takinoya/EvbPusher/FW.Arduino/Readme.md

Supported Main Boards

- AVR based
    - MB-C2 with Arduino Nano
    - MB-C2 with Arduino Nano Every
- Renesas R4 based
    - MB-C2 with Arduino Nano R4
- RP2040 based
    - MB-95x27 (Seeed Xiao RP2040)
    - MB-B1 (AE-RP2040 as RaspberryPI-Pico)
- RP2350 based
    - (Planning...)
