takinoya/EvbPusher/Supplemental/AE-RELAY4-BOARD.SATA-Power-SW/README.ja.md

[English](README.md) | [日本語](README.ja.md)
----

# AE-RELAY4-BOARD SATA-Power switching Custom

## Overview
TBD
