takinoya/EvbPusher/Supplemental/AE-RELAY4-BOARD.SATA-Power-SW/README.md

[English](README.md) | [Japanese](README.ja.md)
----

# SFX Power Complex

TBD
\(Original is here ==> [Japanese](README.ja.md)\)
