takinoya/EvbPusher/Supplemental/SFX-Breakout/README.md

[English](README.md) | [Japanese](README.ja.md)
----

# SFX Breakout board

TBD
\(Original is here ==> [Japanese](README.ja.md)\)
