takinoya/EvbPusher/Supplemental/SFX-Breakout/Shell/SFX-BO-01_Top-Panel_Acrylic-cut.intermediate.pdf

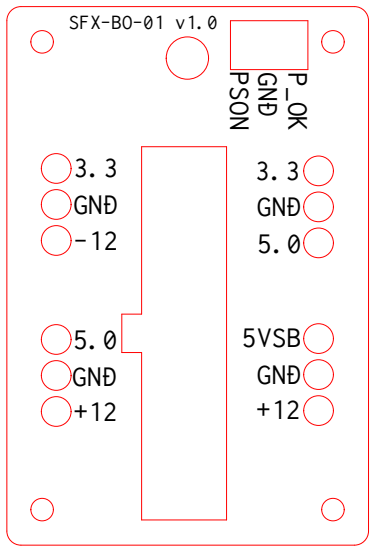
[picture p3: figure]
3. 3 GND -12; 5. 0 GND; GND; 5VSB; 3. 3 PSON GND P_OK; SFX-BO-01 v1. 0
