takinoya/EvbPusher/MB-C1.Arduino_Nano_Every/Shell/03_Acryl-cover.cut.pdf

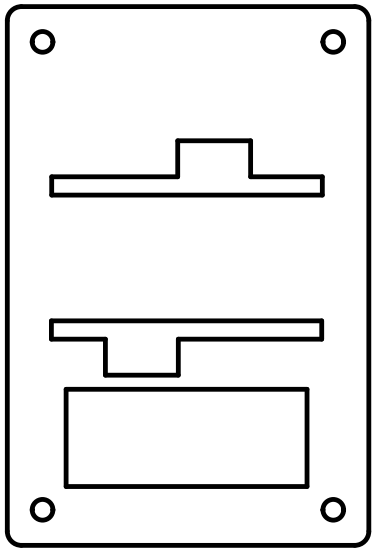
[picture p4: figure]
