takinoya/EvbPusher/MB-C1.Arduino_Nano_Every/photo/PXL_20251028_014240596.jpg

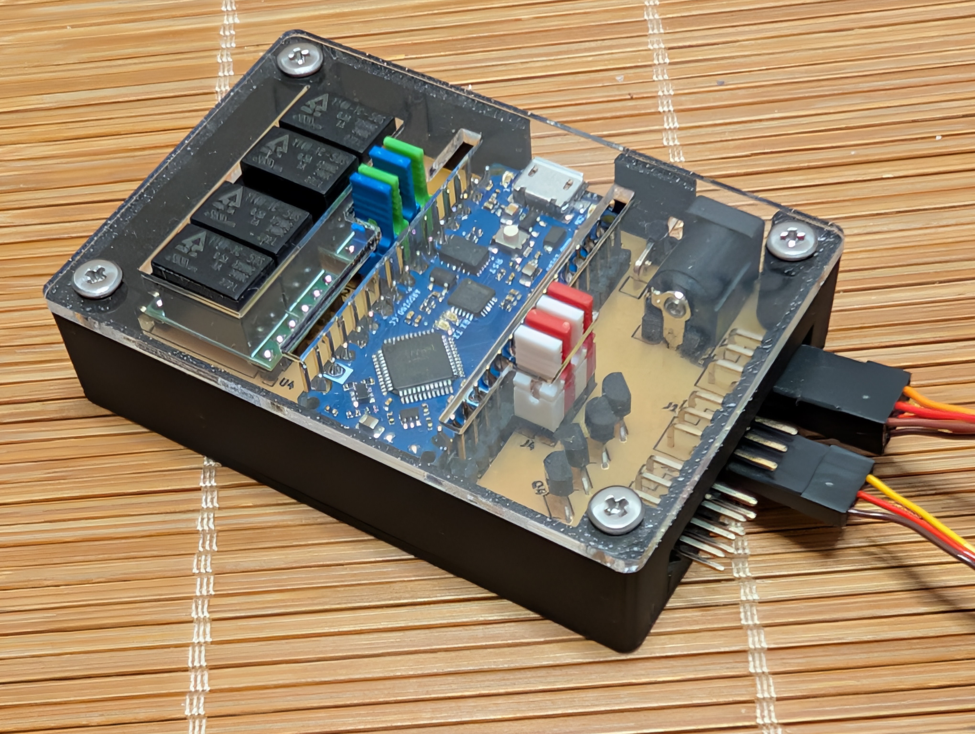
MB-C1.Arduino_Nano_Every/photo/PXL_20251028_014240596.jpg
