takinoya/EvbPusher/MB-C2.Auduino_Nano_R4/Photos/PXL_20251215_010732840.jpg

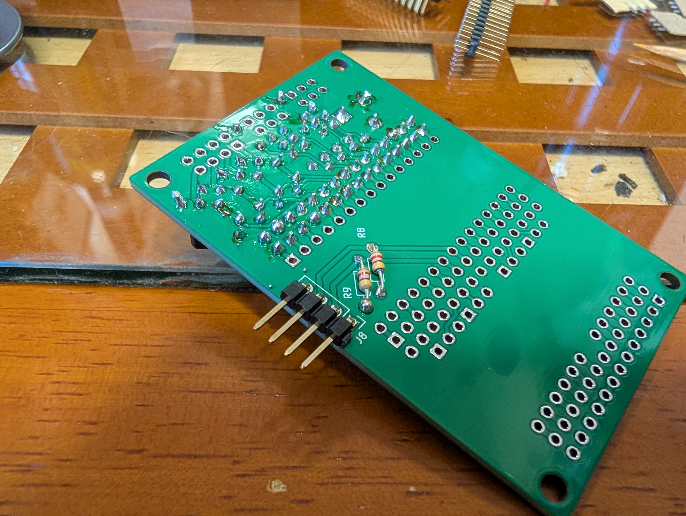
MB-C2.Auduino_Nano_R4/Photos/PXL_20251215_010732840.jpg
