takinoya/EvbPusher/MB-C2.Auduino_Nano_R4/Photos/PXL_20251215_010748415.jpg

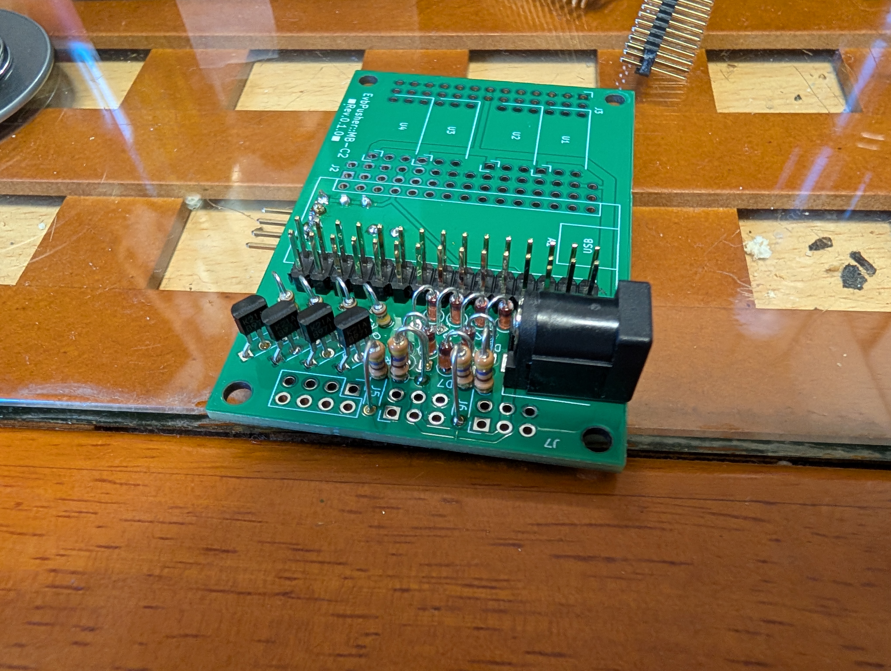
MB-C2.Auduino_Nano_R4/Photos/PXL_20251215_010748415.jpg
