takinoya/EvbPusher/MB-C2.Auduino_Nano_R4/Photos/PXL_20260118_062052821.jpg

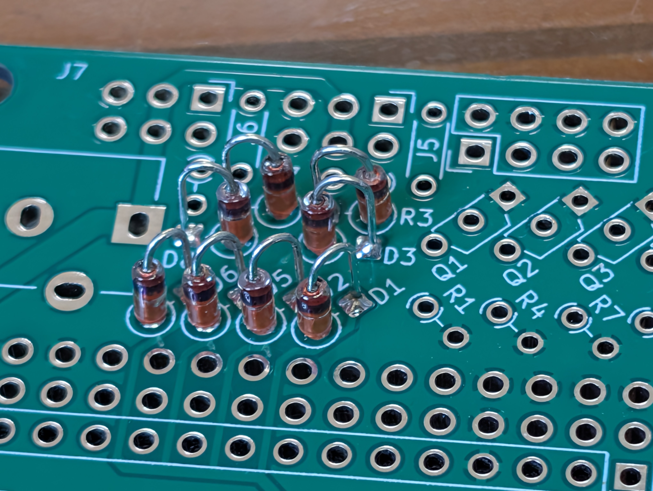
MB-C2.Auduino_Nano_R4/Photos/PXL_20260118_062052821.jpg
