takinoya/EvbPusher/MB-C2.Auduino_Nano_R4/Photos/PXL_20260118_070423665.jpg

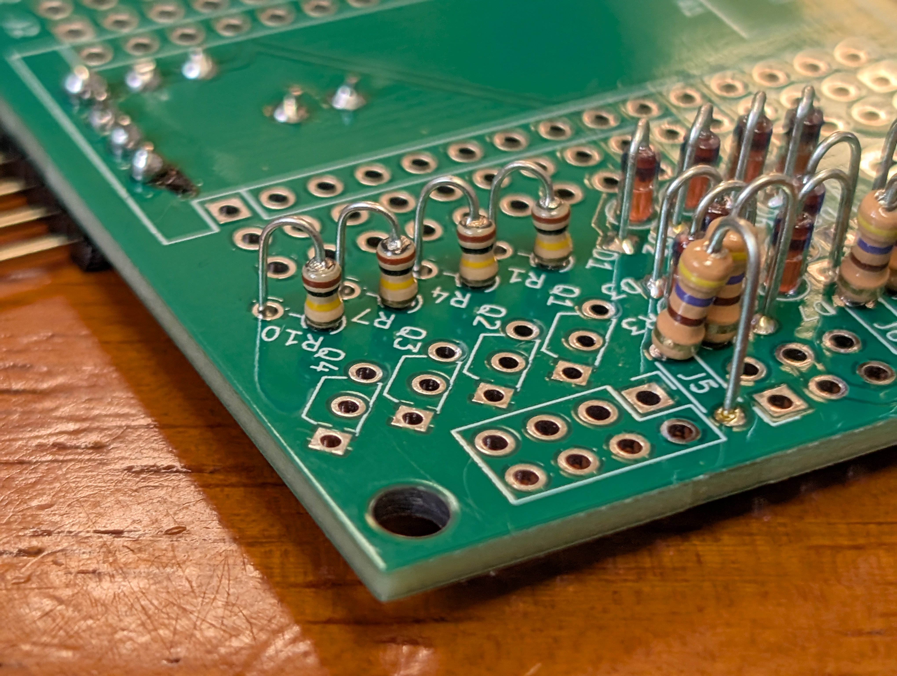
MB-C2.Auduino_Nano_R4/Photos/PXL_20260118_070423665.jpg
