takinoya/EvbPusher/Supplemental/AE-RELAY953B-5V.SATA-Power-SW/photo/PXL_20251104_105322829.jpg

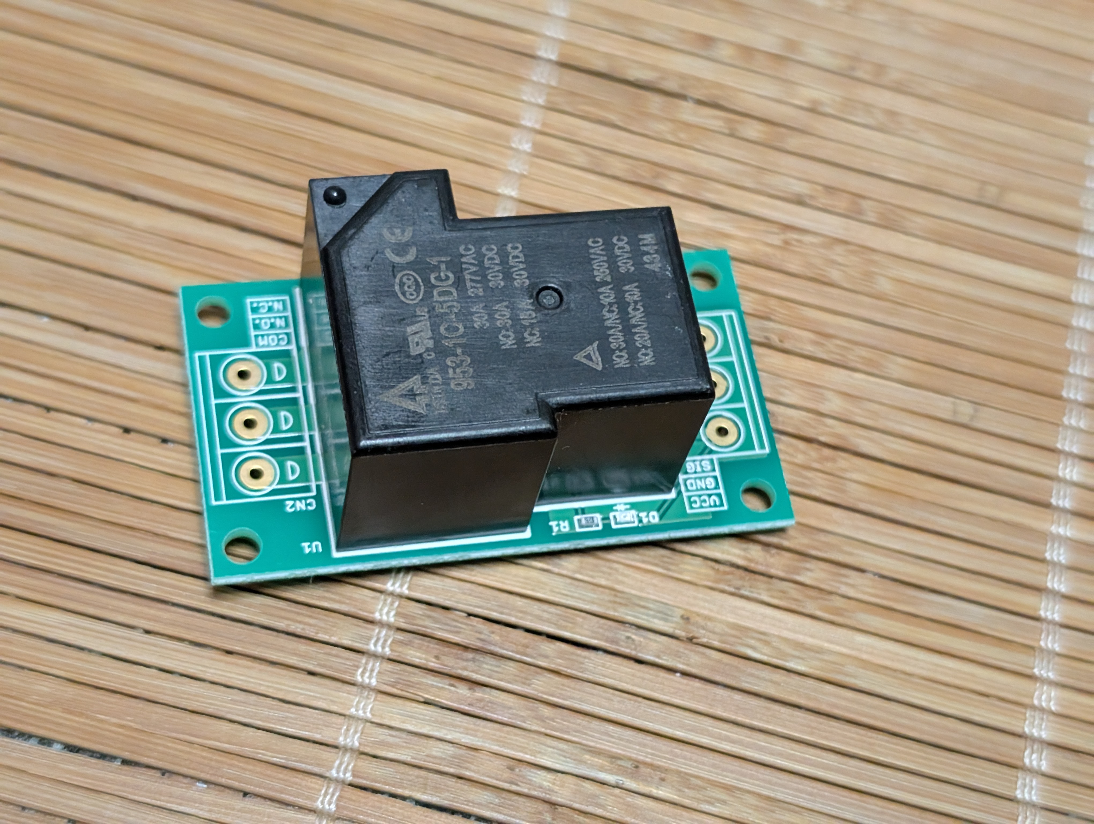
Supplemental/AE-RELAY953B-5V.SATA-Power-SW/photo/PXL_20251104_105322829.jpg
