takinoya/EvbPusher/Supplemental/AE-RELAY953B-5V.SATA-Power-SW/photo/PXL_20251105_040740281.jpg

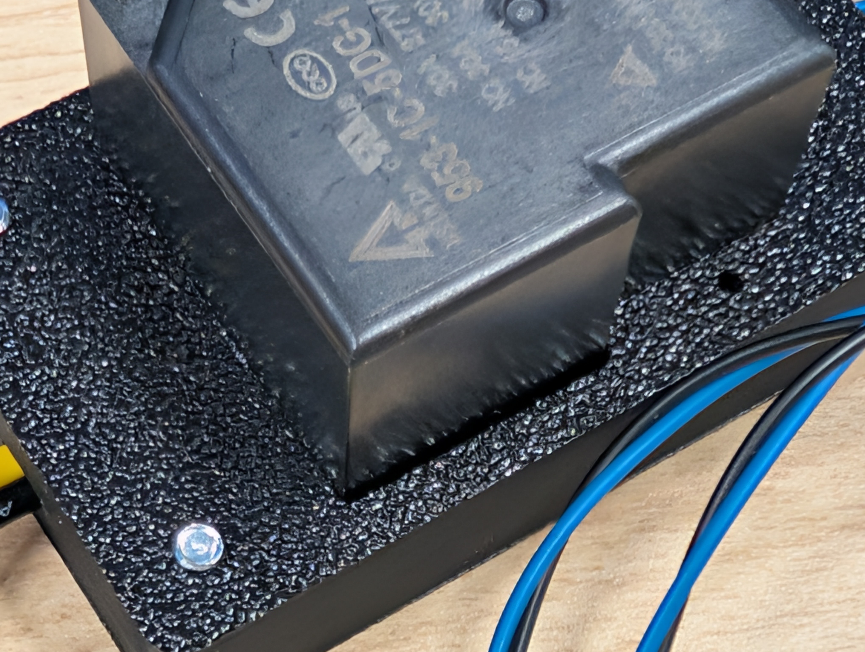
Supplemental/AE-RELAY953B-5V.SATA-Power-SW/photo/PXL_20251105_040740281.jpg
