takinoya/EvbPusher/MB-C1.Arduino_Nano_Every/Shell/02_Top_main_v2.FCStd

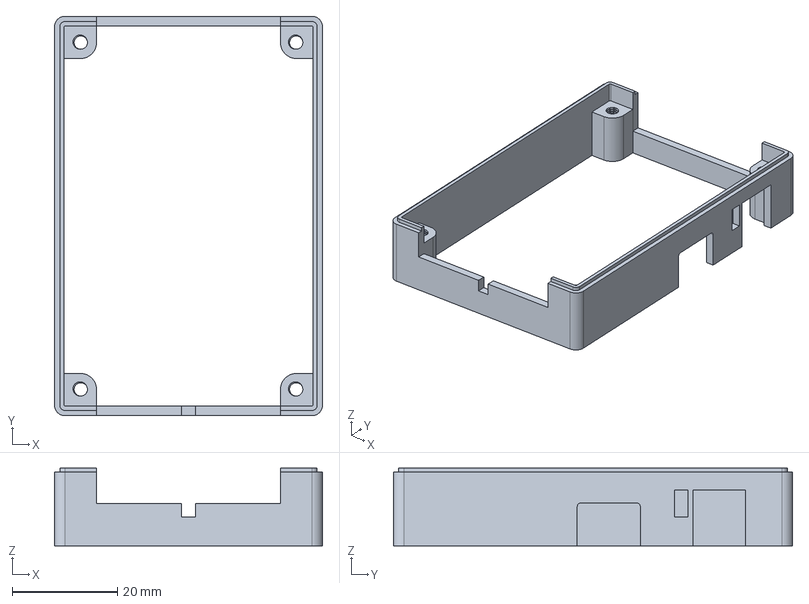
[picture p20: CAD file, 2025-10-31]
MB-C1.Arduino_Nano_Every/Shell/02_Top_main_v2.FCStd
51.0 x 76.0 x 14.8 mm
