takinoya/EvbPusher/MB-C2.Auduino_Nano_R4/Shell/02_Main_body.3mf

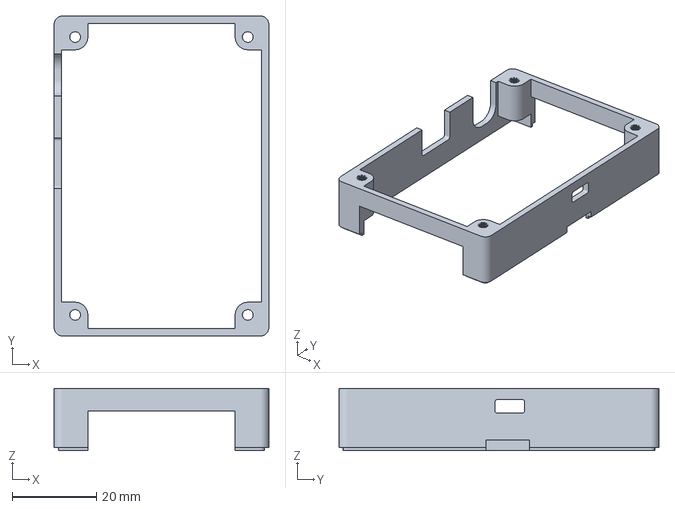
[picture p21: CAD file, 2026-03-13]
MB-C2.Auduino_Nano_R4/Shell/02_Main_body.3mf
51.0 x 76.0 x 14.8 mm
