takinoya/EvbPusher/MB-C1.Arduino_Nano_Every/Shell/01_Bottom_panel_v2-Body.3mf

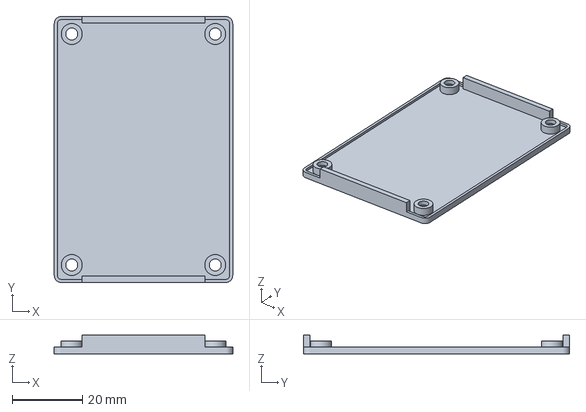
[picture p22: CAD file, 2025-10-31]
MB-C1.Arduino_Nano_Every/Shell/01_Bottom_panel_v2-Body.3mf
51.0 x 76.0 x 5.34 mm
