takinoya/EvbPusher/MB-C2.Auduino_Nano_R4/Shell/MB-C2_Shell.FCStd

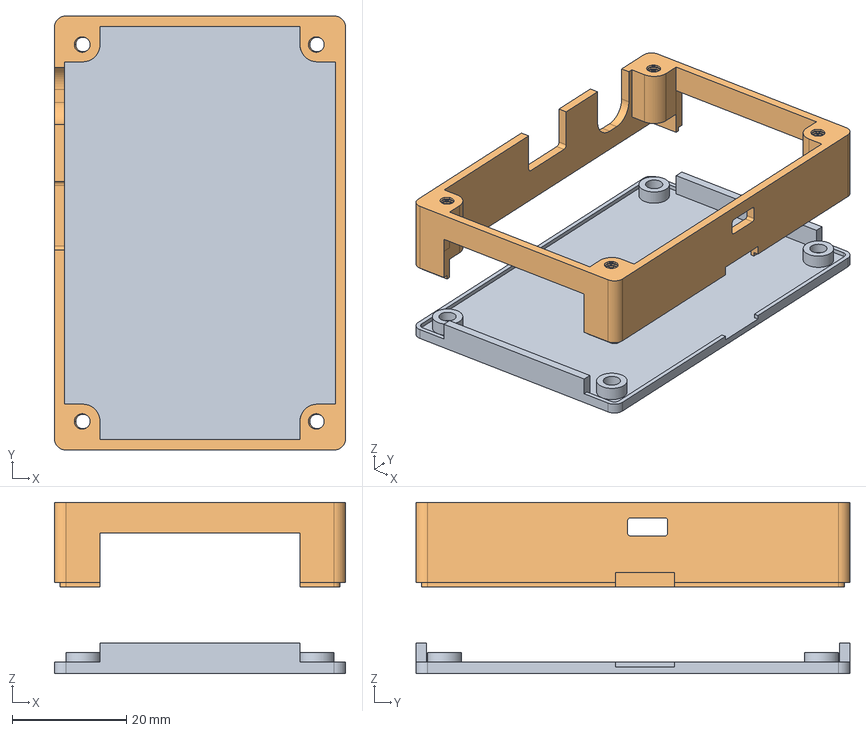
[picture p23: CAD file, 2026-03-13]
MB-C2.Auduino_Nano_R4/Shell/MB-C2_Shell.FCStd
51.0 x 76.0 x 30.0 mm
01_Bottom_panel
02_Main_body
