takinoya/EvbPusher/Supplemental/AE-RELAY953B-5V.SATA-Power-SW/ORCA.Shell_for_AE-RELAY953B.3mf

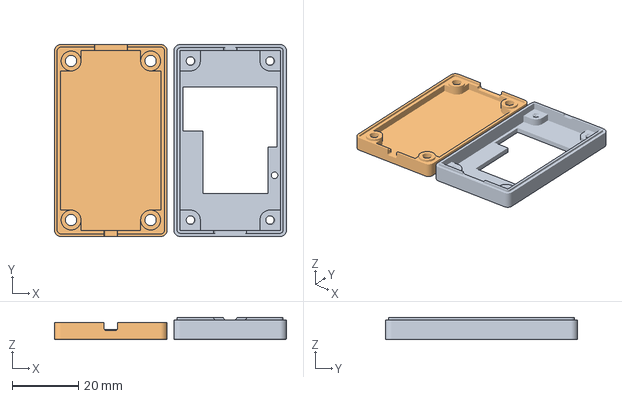
[picture p24: CAD file, 2025-11-11]
Supplemental/AE-RELAY953B-5V.SATA-Power-SW/ORCA.Shell_for_AE-RELAY953B.3mf
70.0 x 58.0 x 6.74 mm
