takinoya/EvbPusher/Supplemental/SFX-Breakout/Shell/SFX-BO-01_Shell-North-Body.3mf

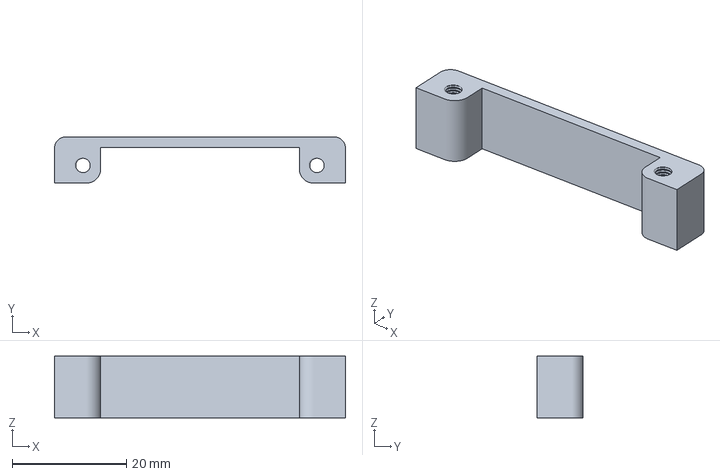
[picture p25: CAD file, 2026-03-12]
Supplemental/SFX-Breakout/Shell/SFX-BO-01_Shell-North-Body.3mf
51.0 x 8.10 x 10.8 mm
