takinoya/EvbPusher/Supplemental/AE-RELAY953B-5V.SATA-Power-SW/Shell_for_AE-RELAY953B-5V-Bottom-panel-Body.3mf

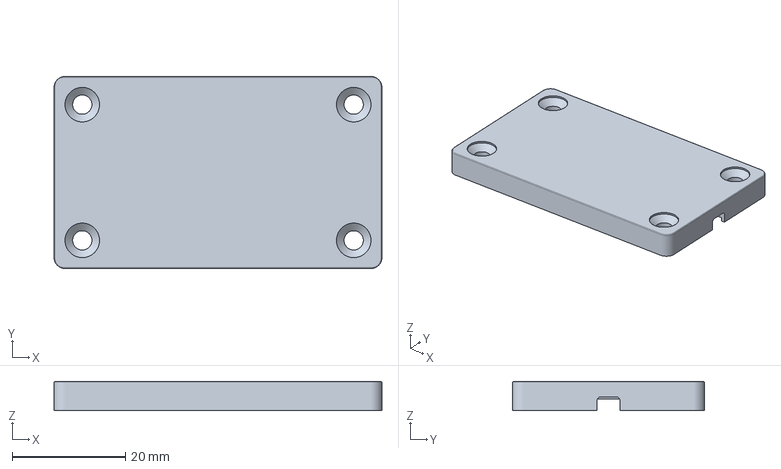
[picture p26: CAD file, 2025-11-11]
Supplemental/AE-RELAY953B-5V.SATA-Power-SW/Shell_for_AE-RELAY953B-5V-Bottom-panel-Body.3mf
58.0 x 34.0 x 5.14 mm
