takinoya/EvbPusher/MB-C2.Auduino_Nano_R4/Shell/MB-C2_CN-CAPs-CAP2.54pin-1x03_Body.3mf

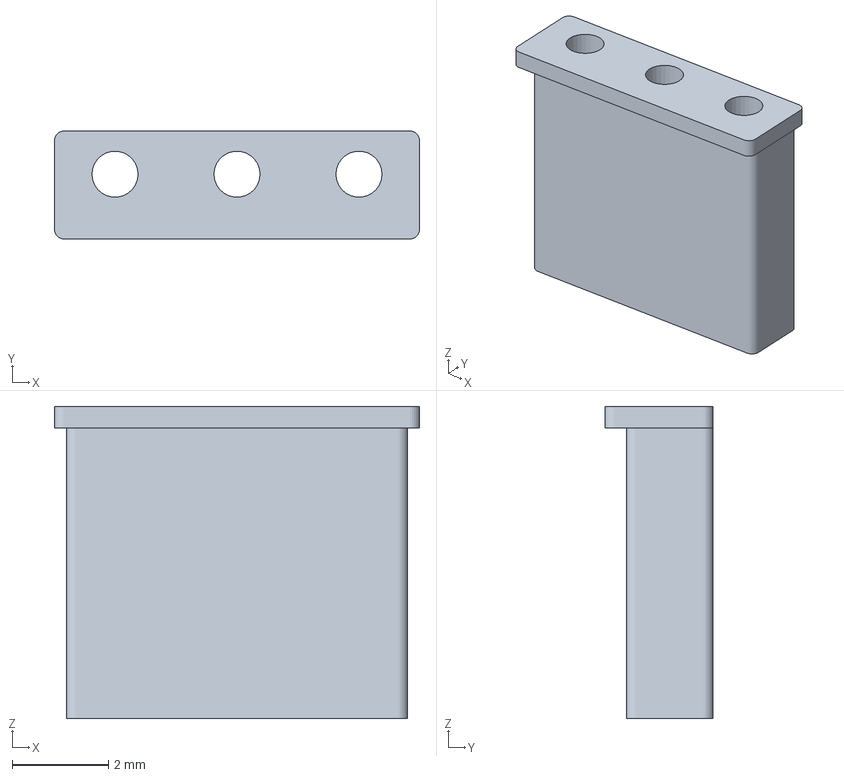
[picture p27: CAD file, 2026-03-13]
MB-C2.Auduino_Nano_R4/Shell/MB-C2_CN-CAPs-CAP2.54pin-1x03_Body.3mf
7.60 x 2.25 x 6.50 mm
