takinoya/EvbPusher/Supplemental/AE-RELAY953B-5V.SATA-Power-SW/Shell_for_AE-RELAY953B-5V-Top-Cover-Body.3mf

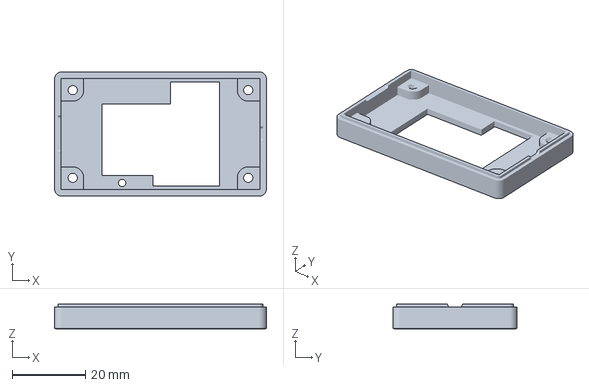
[picture p28: CAD file, 2025-11-11]
Supplemental/AE-RELAY953B-5V.SATA-Power-SW/Shell_for_AE-RELAY953B-5V-Top-Cover-Body.3mf
58.0 x 34.0 x 6.74 mm
