takinoya/EvbPusher/Supplemental/SFX-Breakout/Shell/SFX-BO-01_Shell-Bottom-TypeB-Body.3mf

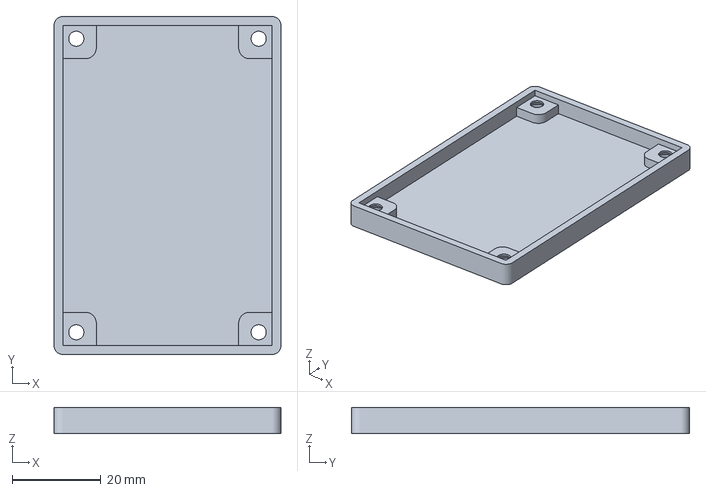
[picture p29: CAD file, 2026-03-12]
Supplemental/SFX-Breakout/Shell/SFX-BO-01_Shell-Bottom-TypeB-Body.3mf
51.0 x 76.0 x 5.94 mm
