takinoya/EvbPusher/MB-C2.Auduino_Nano_R4/Shell/MB-C2_CN-CAPs.FCStd

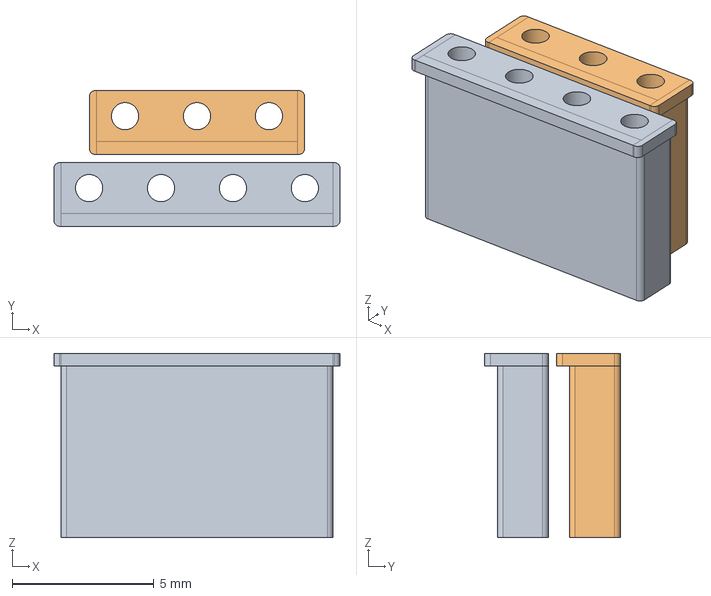
[picture p30: CAD file, 2026-03-13]
MB-C2.Auduino_Nano_R4/Shell/MB-C2_CN-CAPs.FCStd
10.1 x 4.79 x 6.50 mm
CAP2.54pin-1x04_Body
CAP2.54pin-1x03_Body
