takinoya/EvbPusher/Supplemental/AE-RELAY953B-5V.SATA-Power-SW/Shell_for_AE-RELAY953B-5V.FCStd

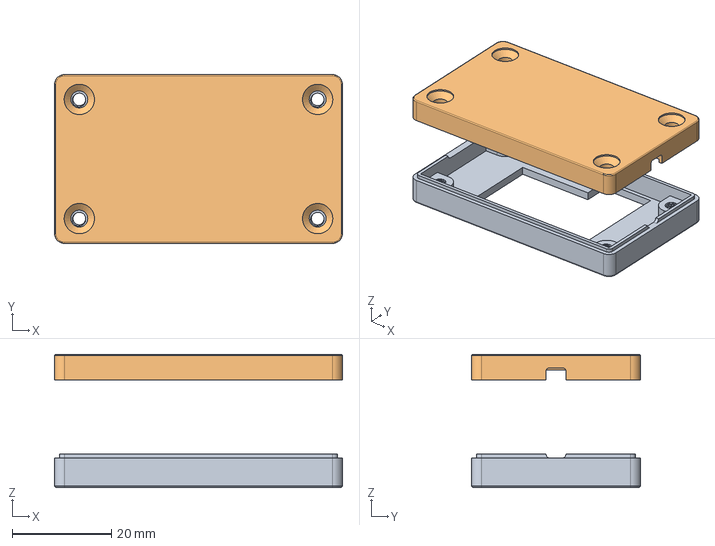
[picture p31: CAD file, 2025-11-11]
Supplemental/AE-RELAY953B-5V.SATA-Power-SW/Shell_for_AE-RELAY953B-5V.FCStd
58.0 x 34.0 x 26.8 mm
Top-Cover-Body
Bottom-panel-Body
