takinoya/EvbPusher/Supplemental/SFX-Breakout/Shell/SFX-BO-01_Shell-Bottom-TypeA-Body.3mf

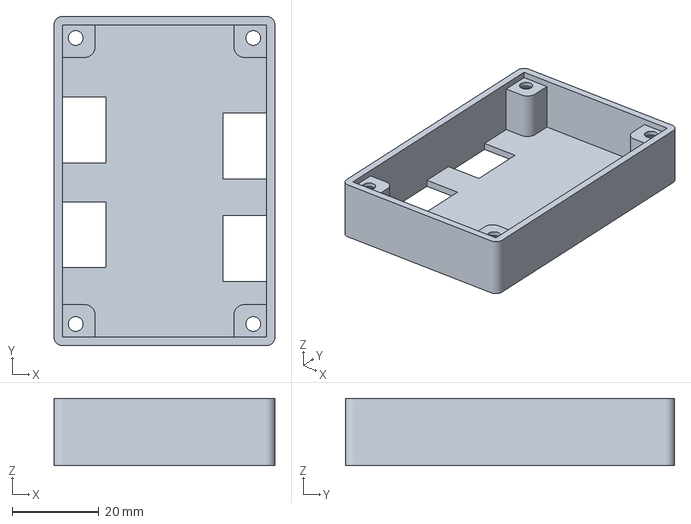
[picture p32: CAD file, 2026-03-12]
Supplemental/SFX-Breakout/Shell/SFX-BO-01_Shell-Bottom-TypeA-Body.3mf
51.0 x 76.0 x 15.5 mm
