takinoya/EvbPusher/MB-C2.Auduino_Nano_R4/Shell/MB-C2_CN-CAPs-CAP2.54pin-1x04_Body.3mf

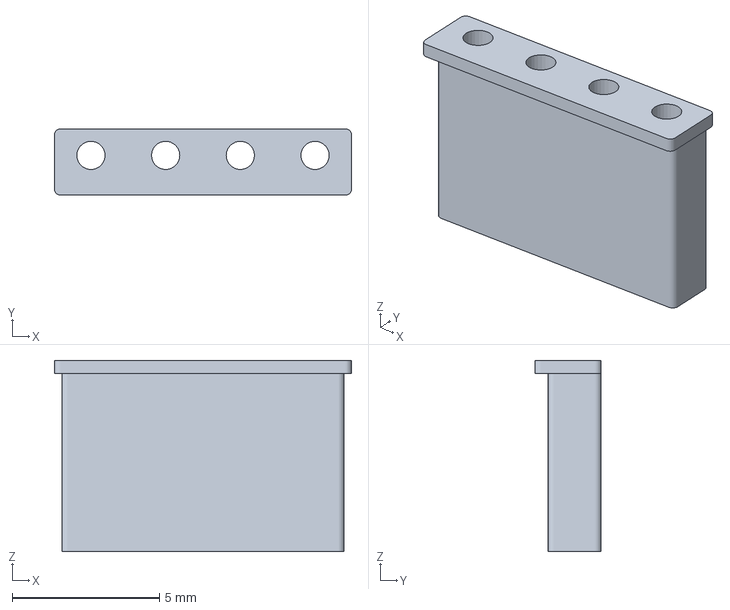
[picture p33: CAD file, 2026-03-13]
MB-C2.Auduino_Nano_R4/Shell/MB-C2_CN-CAPs-CAP2.54pin-1x04_Body.3mf
10.1 x 2.25 x 6.50 mm
