takinoya/EvbPusher/(list of files, cad)

Other CAD files:
MB-C1.Arduino_Nano_Every/Shell/02_Top_main_v2-Body.3mf
MB-C2.Auduino_Nano_R4/Shell/01_Bottom_panel.3mf
Supplemental/SFX-Breakout/Shell/SFX-BO-01_Shell-South-Body.3mf
MB-C1.Arduino_Nano_Every/Shell/01_Bottom_panel_v2.FCStd
Supplemental/AE-RELAY953B-5V.SATA-Power-SW/Object_1_PLA_33m37s.gcode.3mf
MB-C2.Auduino_Nano_R4/Shell/Bambu-A1M0p4_PLA_48m32s.gcode.3mf
Misc/Plastic-Spacer_Nuts/M3_Large-Nut/Nut_M3x2.54_M4-outer.FCStd
Misc/Plastic-Spacer_Nuts/M3_Thumb-Cap/Thumb-Screw-Cap_A_M3_M6-outer-Cap-body.3mf
Misc/Plastic-Spacer_Nuts/M3_Thumb-Cap/Thumb-Screw-Cap_A_M3_M6-outer-Main-body.3mf
Misc/Plastic-Spacer_Nuts/M3_Thumb-Cap/Thumb-Screw-Cap_A_M3_M6-outer.FCStd
