takinoya/EvbPusher/MB-C2.Auduino_Nano_R4/Shell/03_Top-cover.Acryl-Cut.pdf

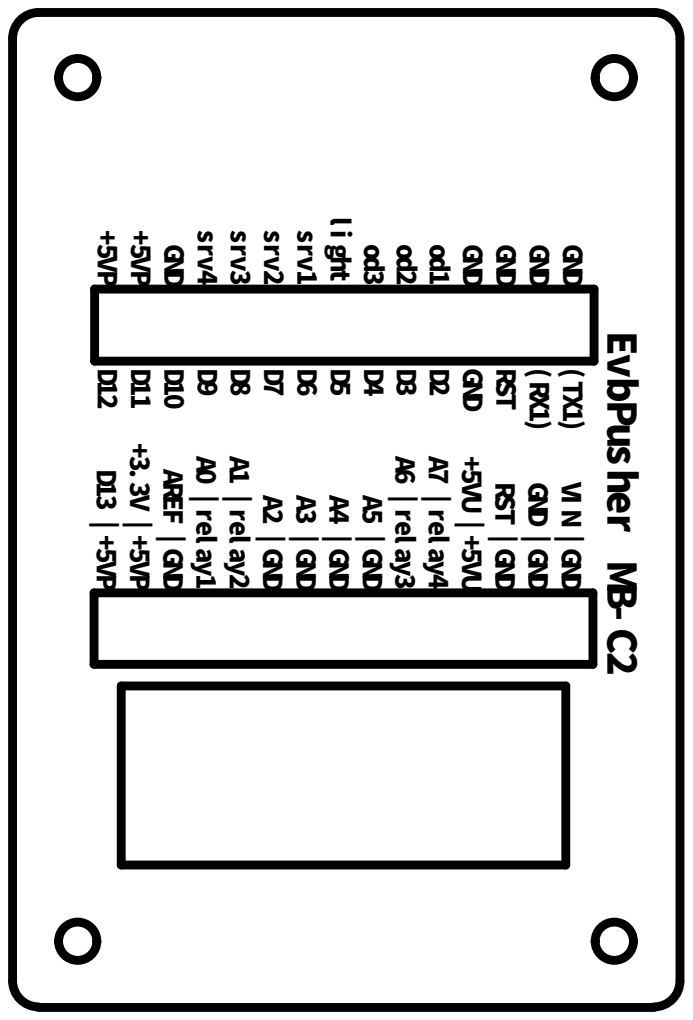
[picture p34: page 1]

od3 od2 od1 GND GND GND GND l i ght +5VP +5VP srv4 srv3 srv2 srv1 GND D12 D11 D10 D9 D8 D7 D6 D5 D4 D3 D2 GND RST ( RX1) ( TX1) EvbPusher MB- C2 RST | GND | GND VI N | GND A6 | rel ay3 A7 | rel ay4 +5VU | +5VU A2 | GND A3 | GND A4 | GND A5 | GND A0 | rel ay1 A1 | rel ay2 AREF | GND +3. 3V | +5VP D13 | +5VP
