takinoya/EvbPusher/MB-C1.Arduino_Nano_Every/kicad/EVBPusher_nano/UV-Print/B-Mask_Edge.pdf

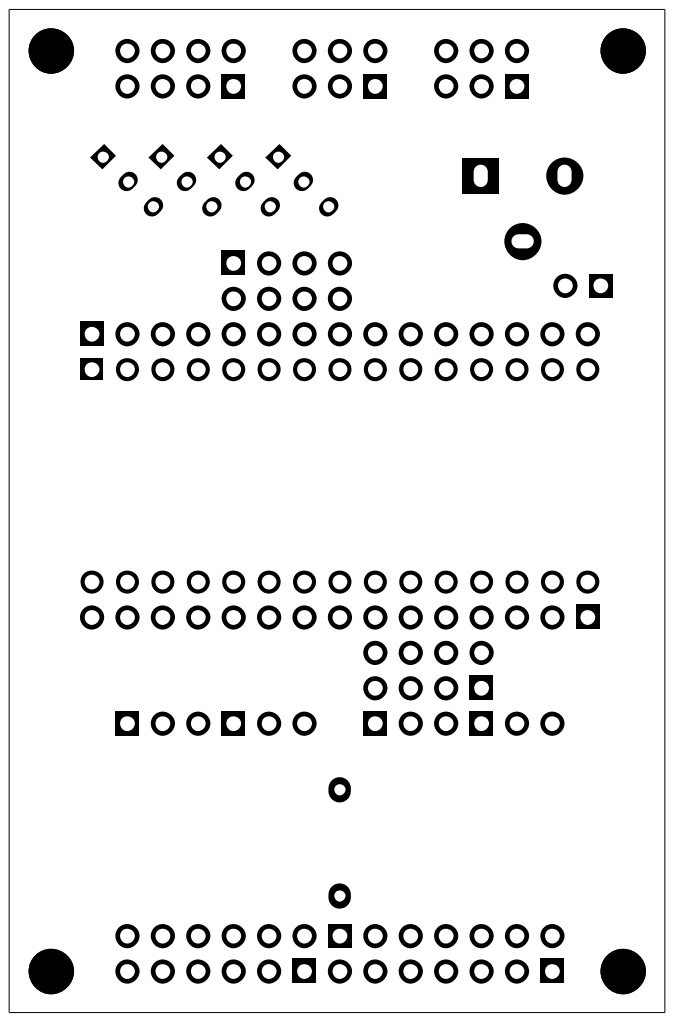
[picture p35: page 1]
