takinoya/EvbPusher/MB-C1.Arduino_Nano_Every/kicad/EVBPusher_nano/UV-Print/Mask.pdf

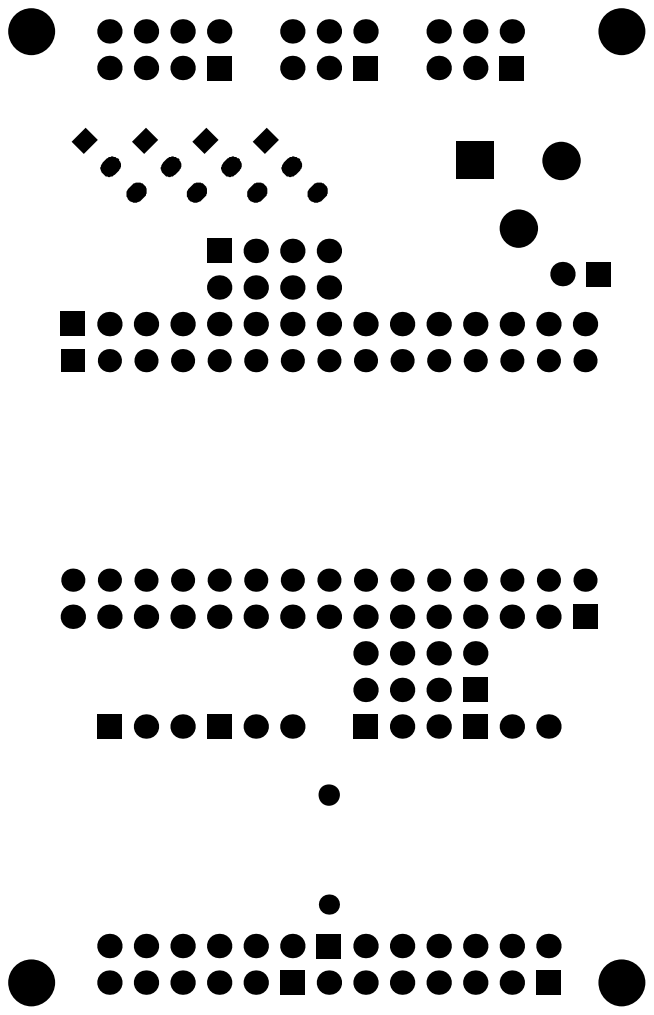
[picture p36: page 1]
