takinoya/EvbPusher/MB-C1.Arduino_Nano_Every/kicad/EVBPusher_nano/UV-Print/Mask_reversed.pdf

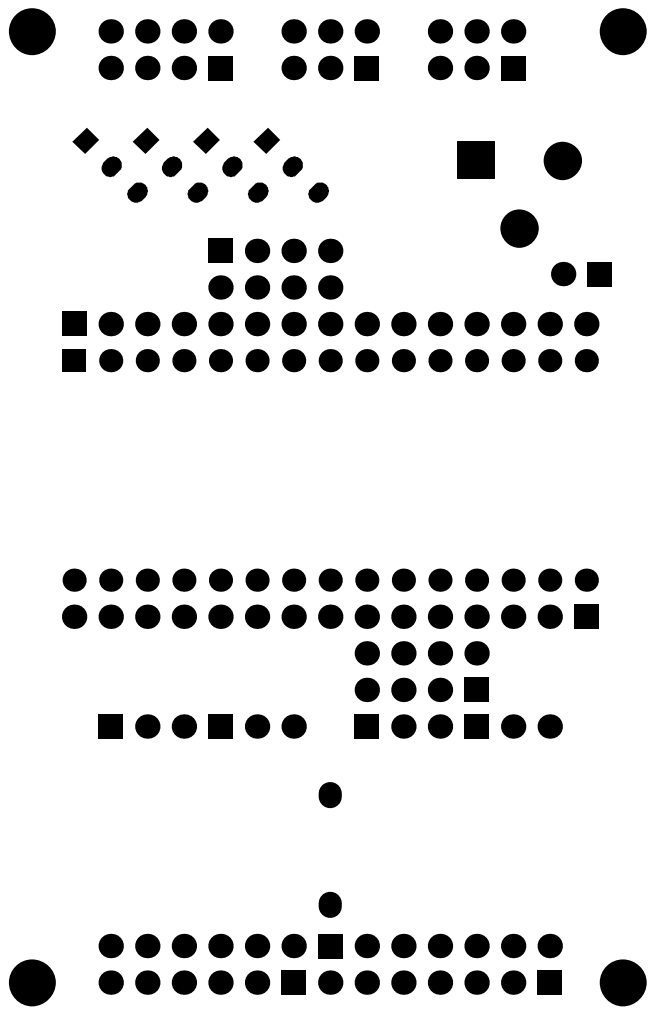
[picture p37: page 1]
