takinoya/EvbPusher/MB-C1.Arduino_Nano_Every/kicad/EVBPusher_nano/UV-Print/Silk.pdf

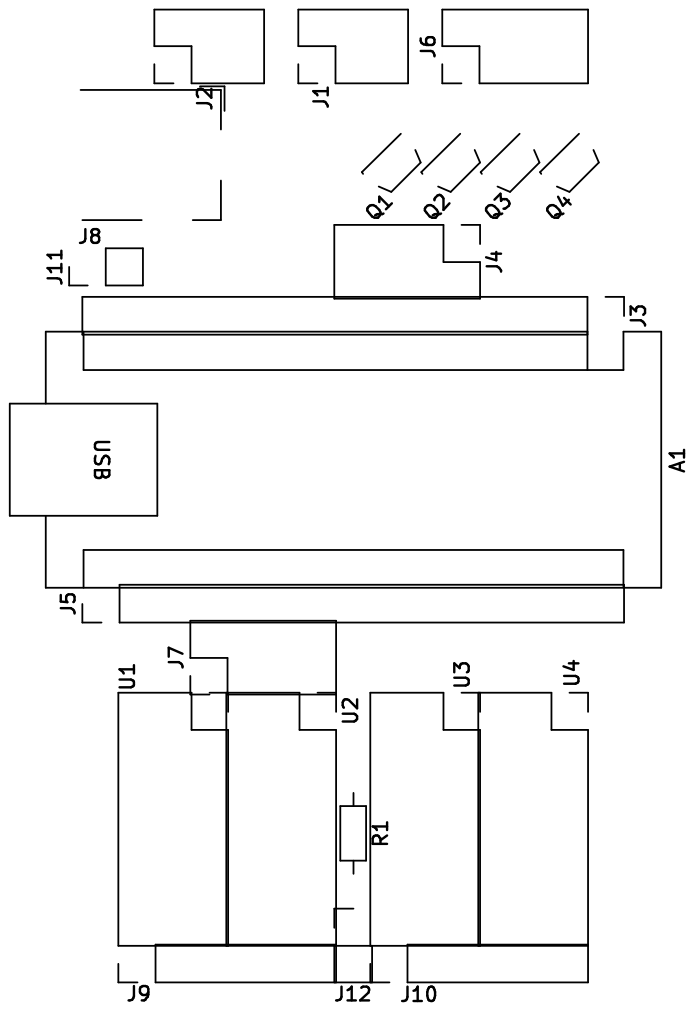
[picture p38: page 1]
