takinoya/EvbPusher/Supplemental/AE-RELAY4-BOARD.SATA-Power-SW/KiCad/AE-RELAY4-BOARD_SATA-Ctrl_A/Garber/For_UV-Print.pdf

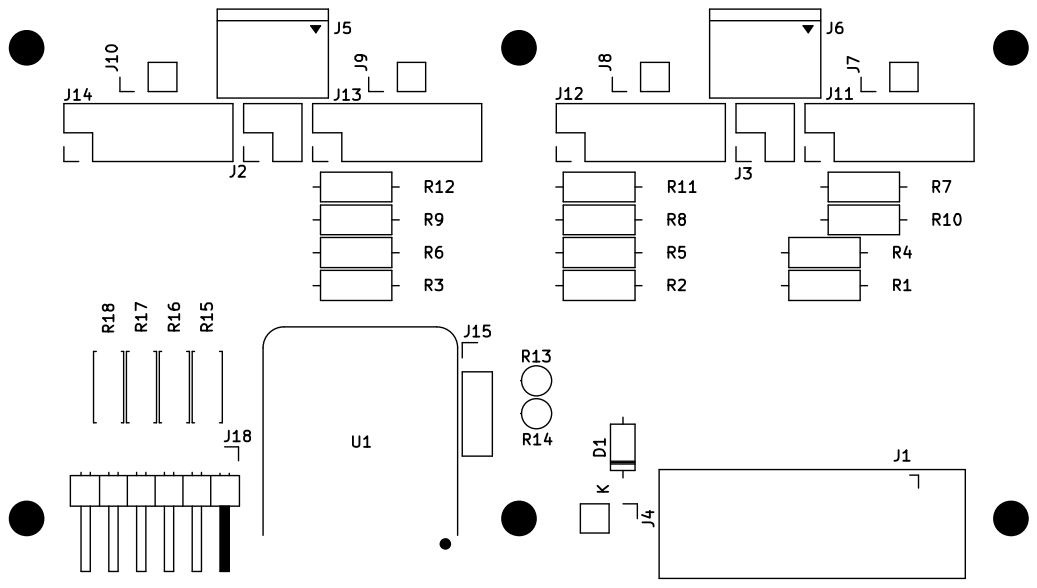
[picture p39: page 1]

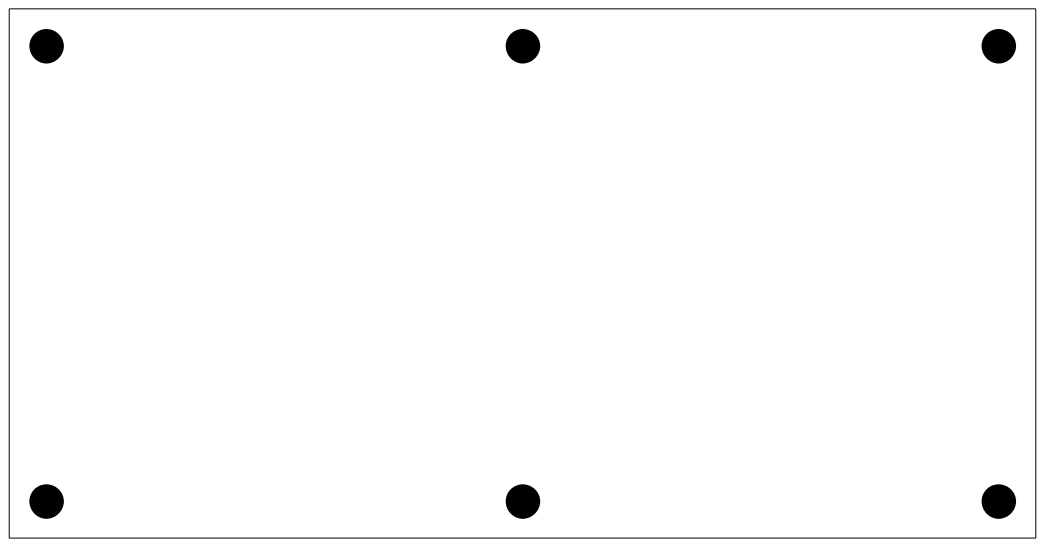
[picture p40: page 2]
