takinoya/EvbPusher/Supplemental/SFX-Breakout/KiCad/SFX-BO-01/Garber/For_UV-Print.pdf

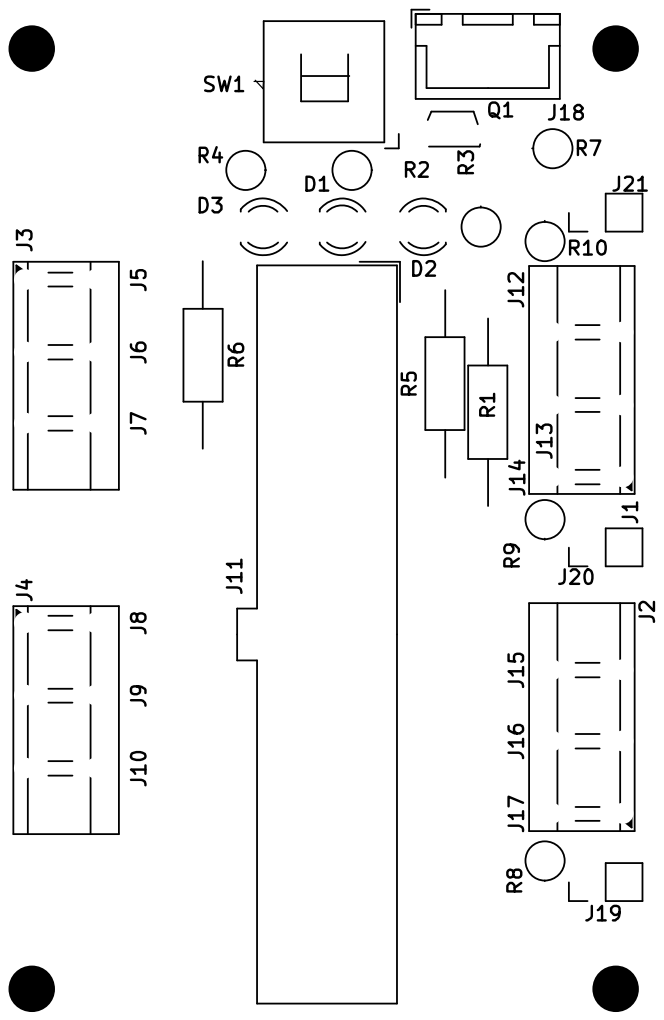
[picture p41: page 1]

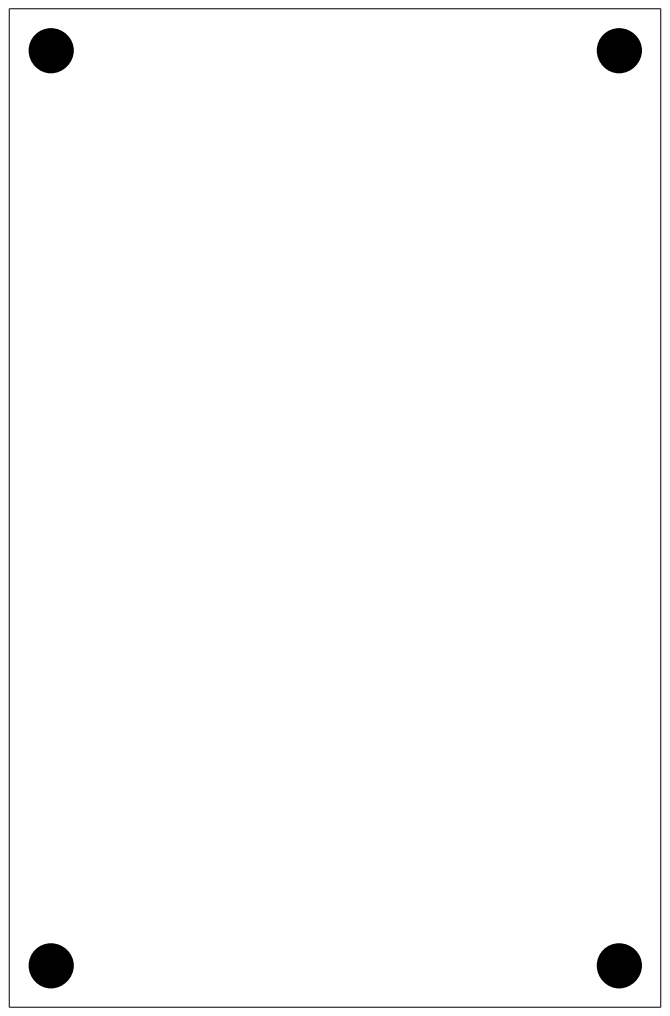
[picture p42: page 2]
