takinoya/EvbPusher/MB-C2.Auduino_Nano_R4/KiCad/MB-C2/MB-C2_sch_Rev.0.1.0.pdf

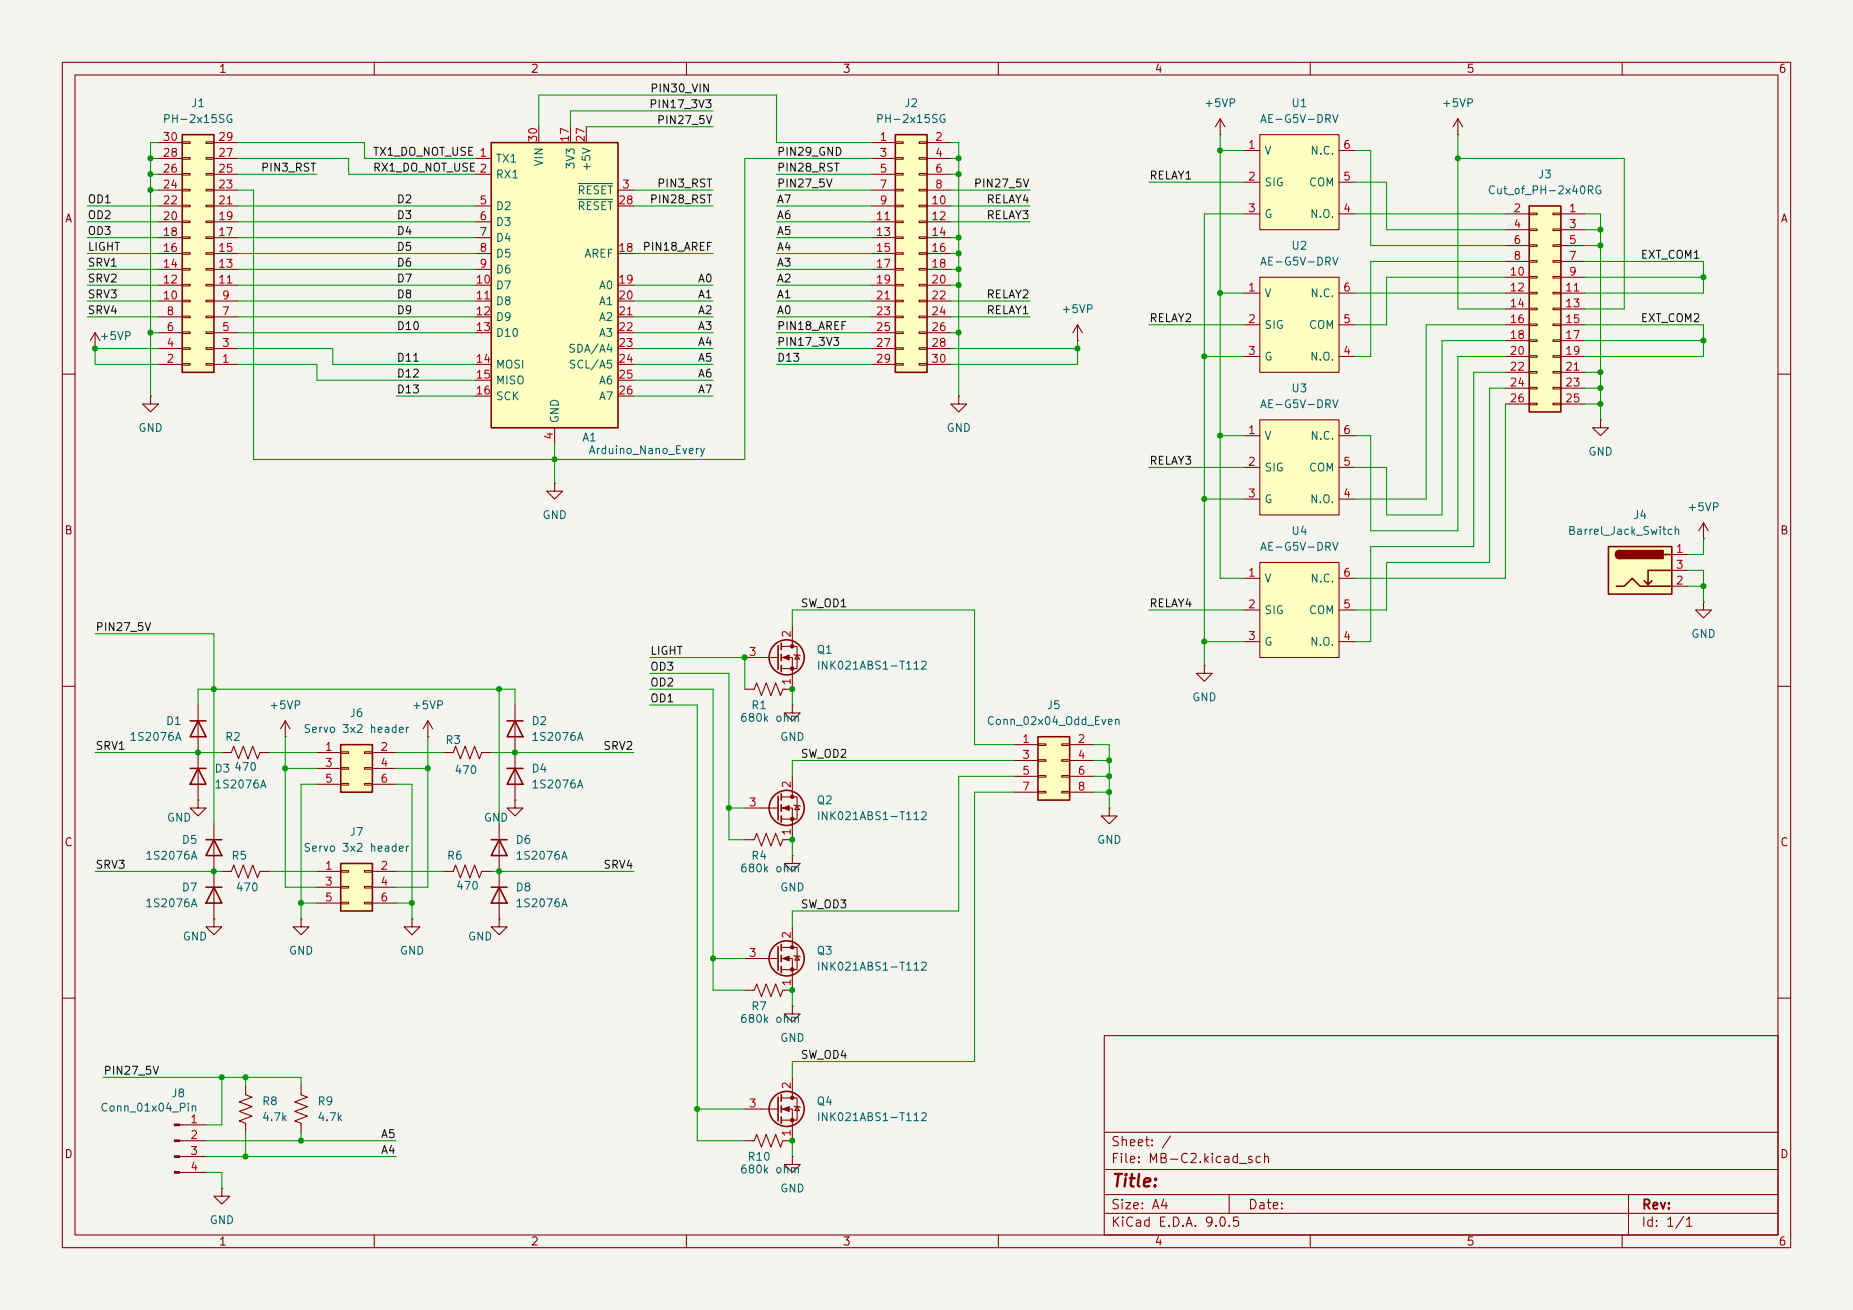
[picture p43: page 1]
