takinoya/EvbPusher/Supplemental/AE-RELAY4-BOARD.SATA-Power-SW/KiCad/AE-RELAY4-BOARD_SATA-Ctrl_A/AE-RELAY4-BOARD_SATA-Ctrl_A.schem-r0p1-1.pdf

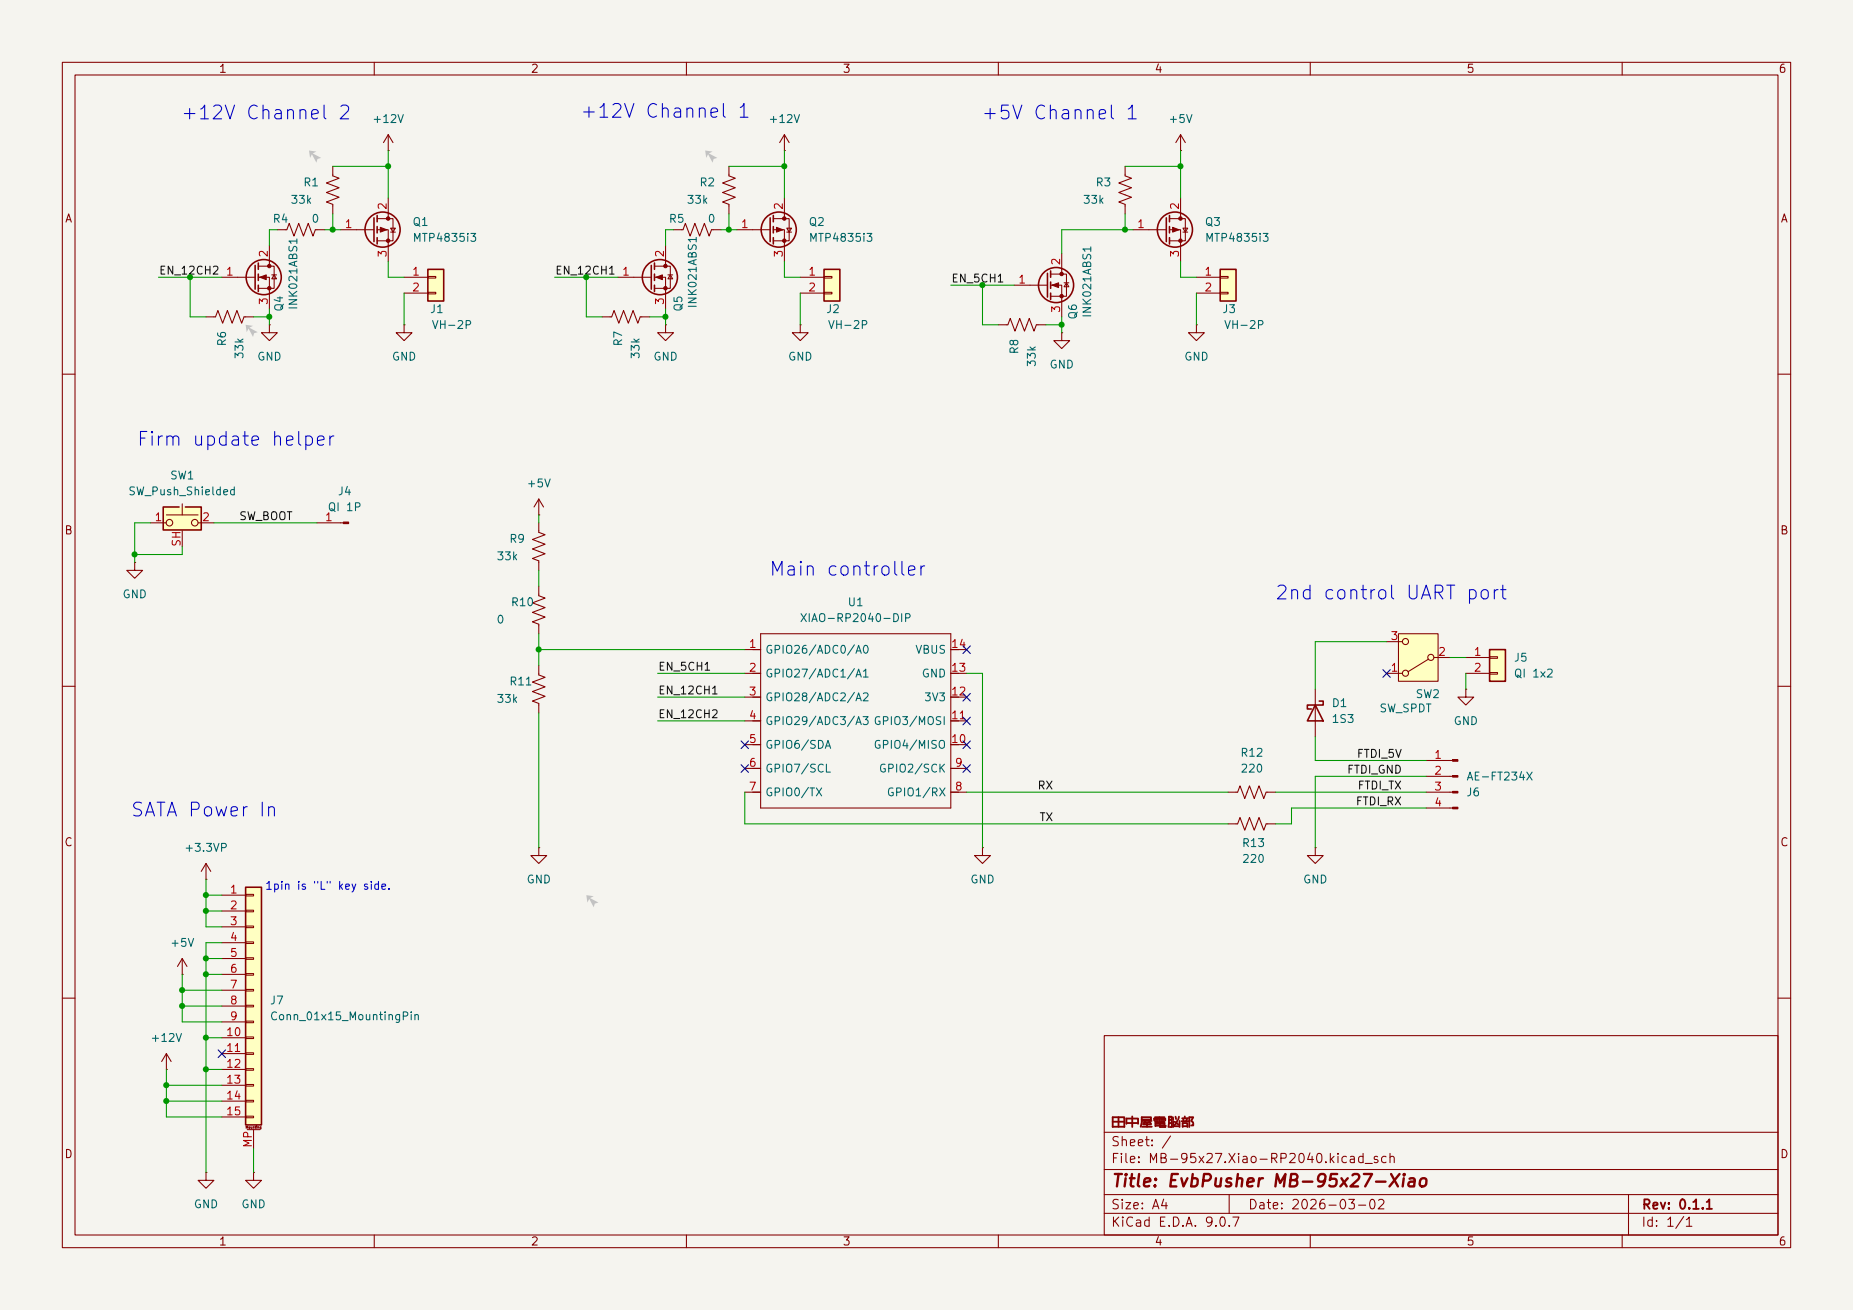
[picture p45: page 1]
