takinoya/EvbPusher/Supplemental/SFX-Breakout/KiCad/SFX-BO-01/SFX-BO-01.r0p0.sch.pdf

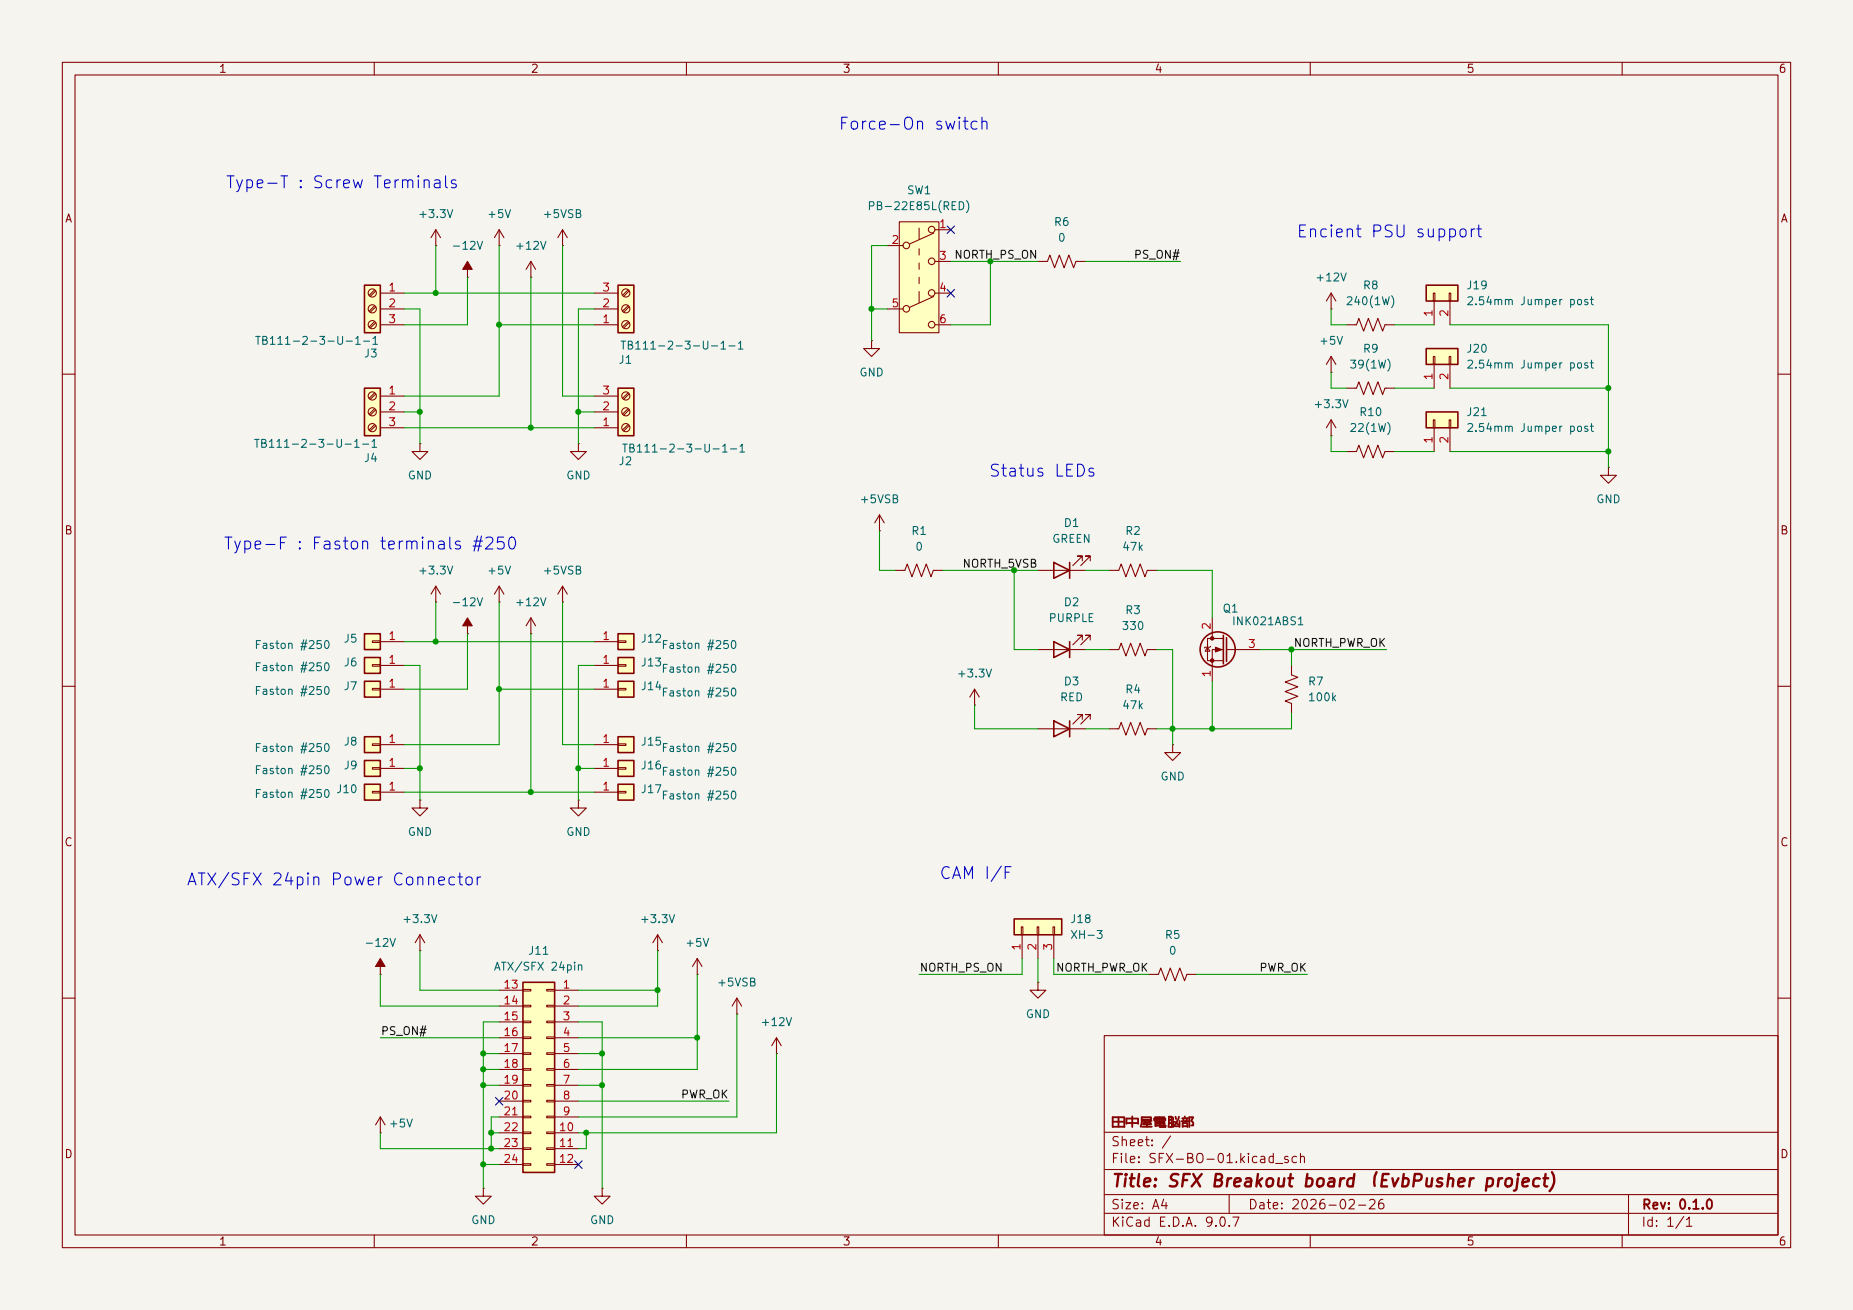
[picture p46: page 1]
