takinoya/EvbPusher/Supplemental/SFX-Breakout/KiCad/SFX-BO-01/Garber/For_Layer-Check.pdf

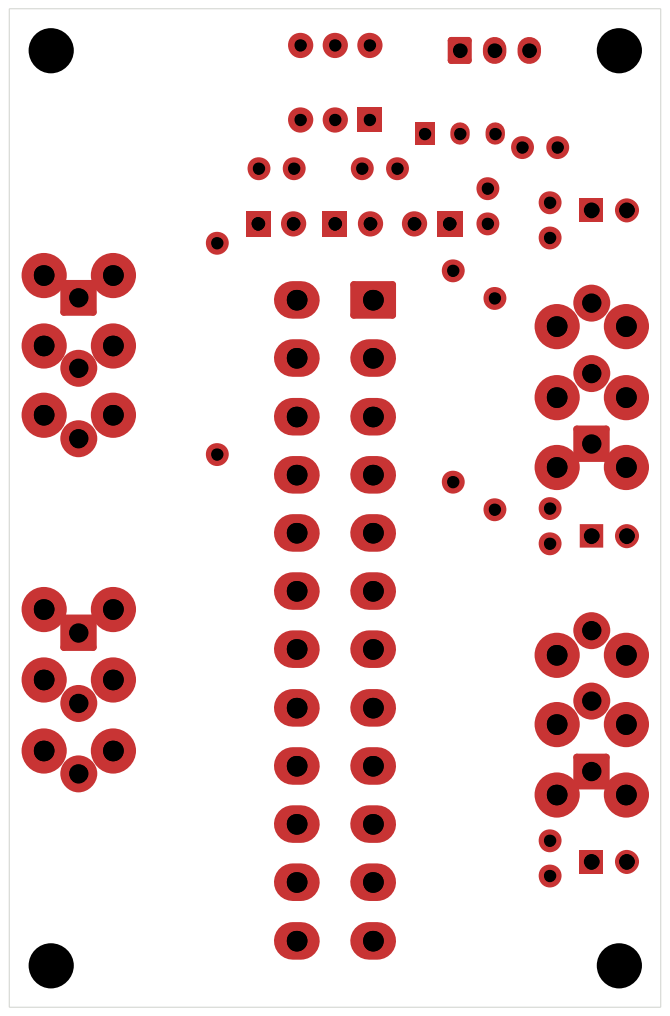
[picture p54: page 1]

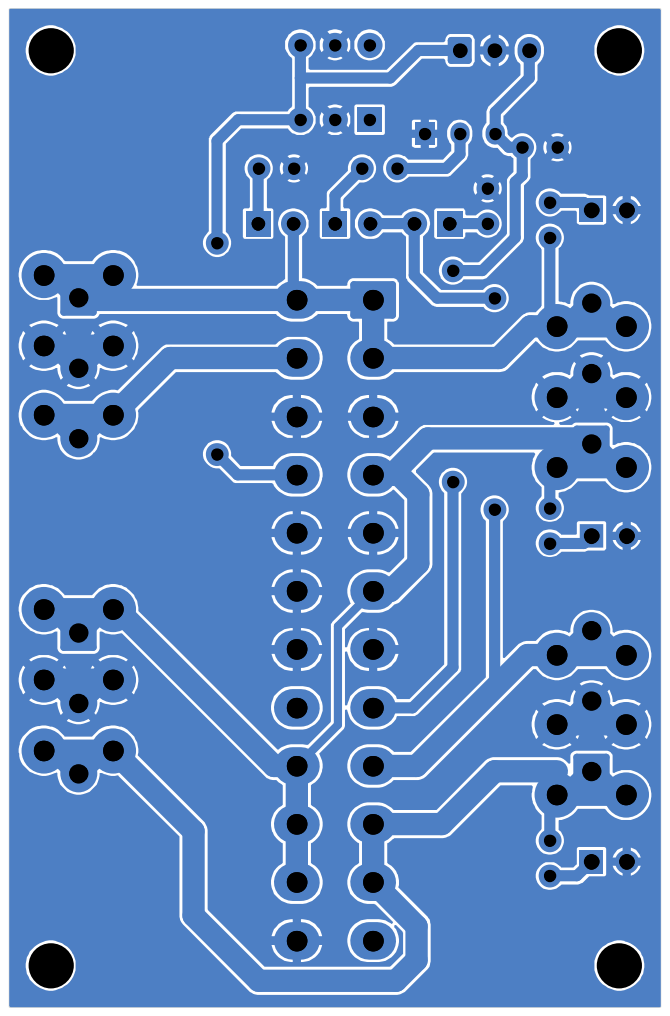
[picture p55: page 2]

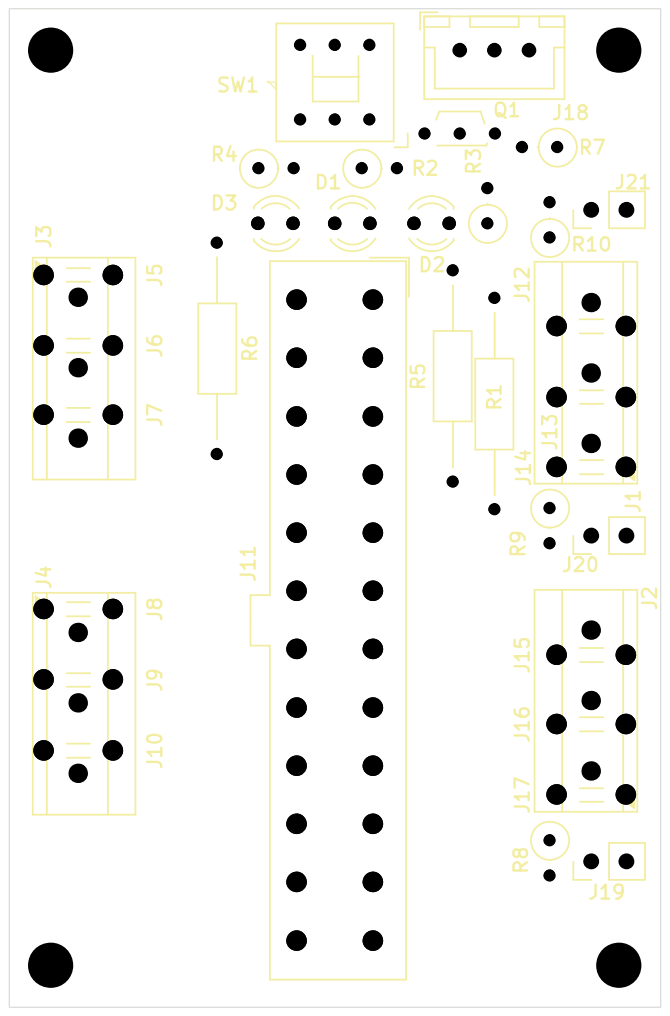
[picture p56: page 3]

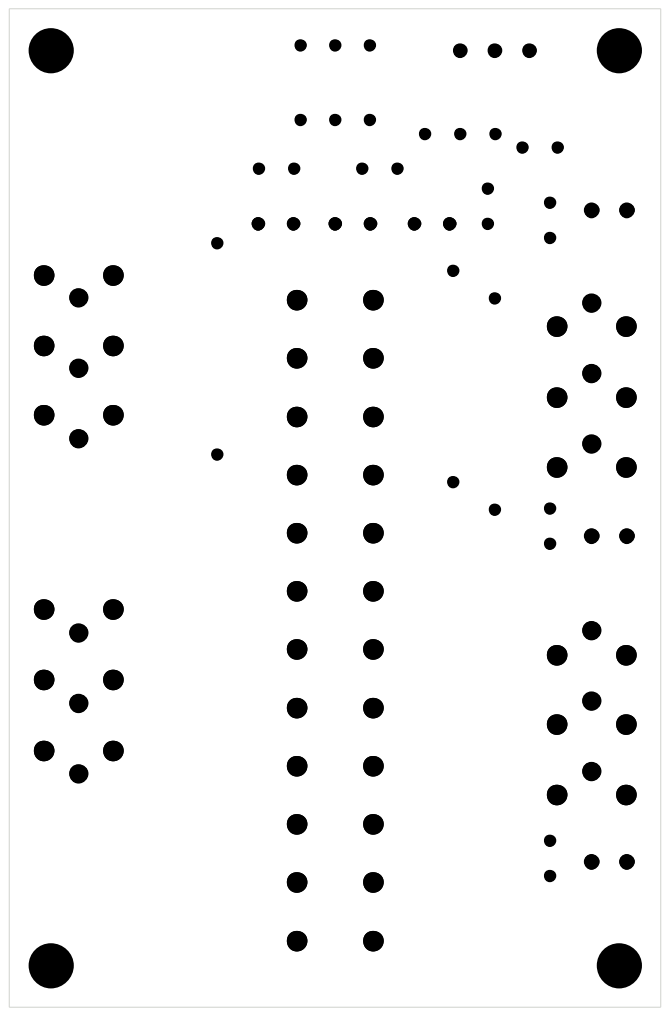
[picture p57: page 4]

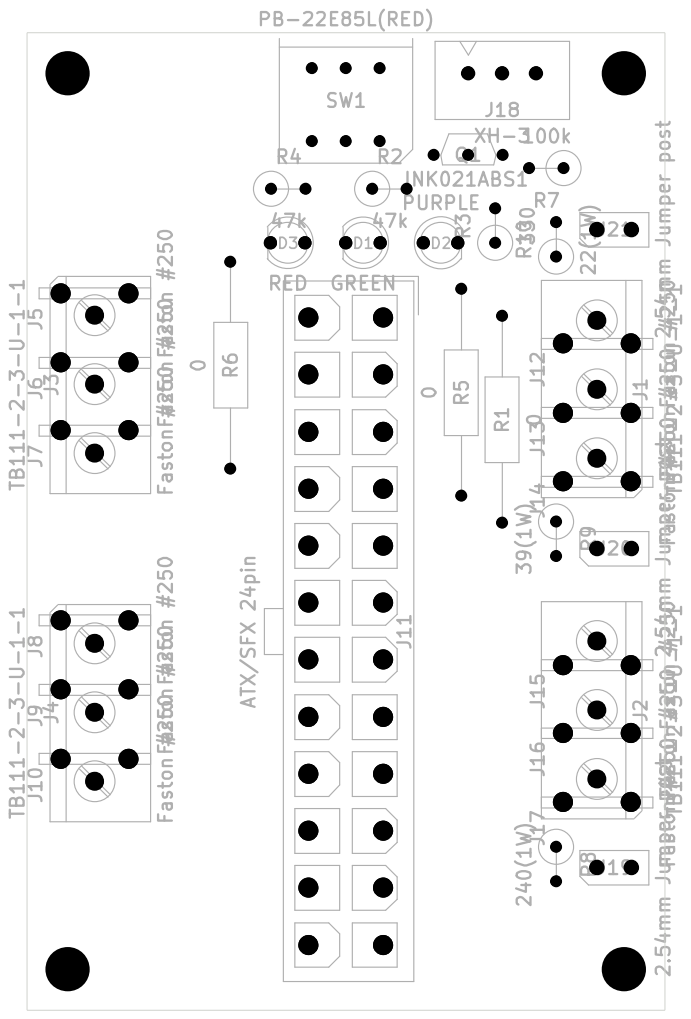
[picture p58: page 6]
