takinoya/EvbPusher/Supplemental/AE-RELAY4-BOARD.SATA-Power-SW/KiCad/AE-RELAY4-BOARD_SATA-Ctrl_A/AE-RELAY4-BOARD_SATA-Ctrl_A.kicad_pcb

## KiCad design Supplemental/AE-RELAY4-BOARD.SATA-Power-SW/KiCad/AE-RELAY4-BOARD_SATA-Ctrl_A/AE-RELAY4-BOARD_SATA-Ctrl_A.kicad_pcb (2026-03-12)

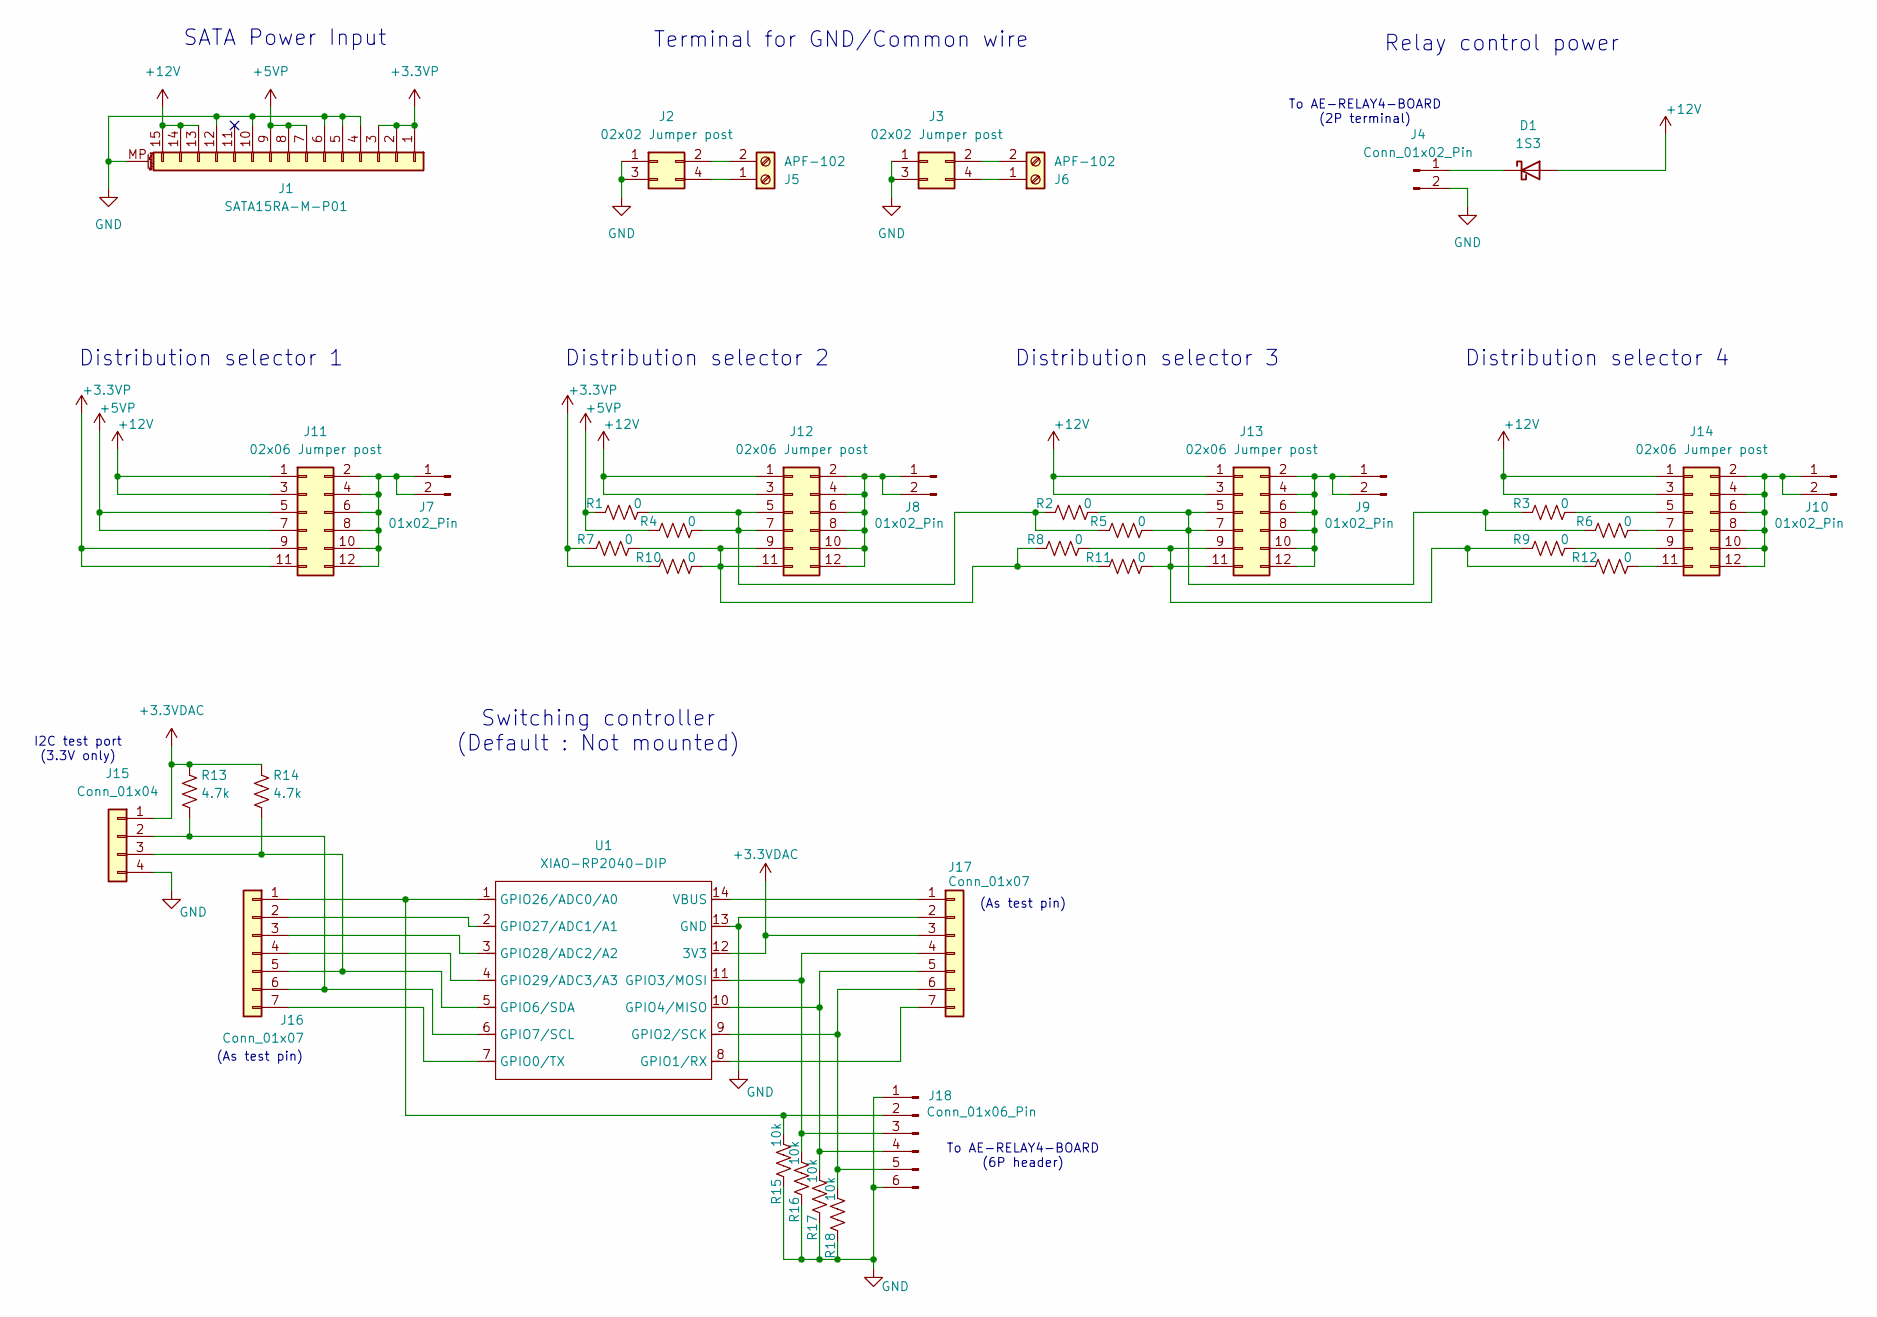
[picture p59: schematic AE-RELAY4-BOARD_SATA-Ctrl_A.kicad_sch, AE-RELAY4-BOARD control/SATA-Power intake board]

Parts:
D1: 1S3; D_DO-35_SOD27_P7.62mm_Horizontal
J1: SATA15RA-M-P01; SATA15RA-M-P01_Vertical_TOSA
J2, J3: 02x02 Jumper post; PinHeader_2x02_P2.54mm_nomargin_Vertical_TOSA
J4: Conn_01x02_Pin; PinHeader_1x02_P2.54mm_nomargin_Vertical_TOSA
J5, J6: APF-102; TerminalBlock_Phoenix_APF-102_1x02_P5.08mm_Horizontal
J7, J8, J9, J10: 01x02_Pin; PinHeader_1x02_P2.54mm_nomargin_Vertical_TOSA
J11, J12, J13, J14: 02x06 Jumper post; PinHeader_2x06_P2.54mm_nomargin_Vertical_TOSA
J15: Conn_01x04; PinHeader_1x04_P2.54mm_Vertical
J16, J17: Conn_01x07; PinHeader_1x07_P2.54mm_nomargin_Vertical_TOSA
J18: Conn_01x06_Pin; PinHeader_1x06_P2.54mm_Horizontal
R1, R2, R3, R4, R5, R6, R7, R8, R9, R10, R11, R12: 0; R_Axial_DIN0207_L6.3mm_D2.5mm_P10.16mm_Horizontal_TOSA
R13, R14: 4.7k; R_Axial_DIN0207_L6.3mm_D2.5mm_P2.54mm_Vertical_TOSA
R15, R16, R17, R18: 10k; R_Axial_DIN0207_L6.3mm_D2.5mm_P7.62mm_Horizontal_TOSA
U1: XIAO-RP2040-DIP

Connections:
+3.3VDAC: J15.1, J17.3, R13.1, R14.1, U1.12 (3V3)
+3.3VP: J1.1, J1.2, J1.3, J11.9, J11.11, R7.1, R10.1
+5VP: J1.7, J1.8, J1.9, J11.5, J11.7, R1.1, R4.1
+12V: D1.2 (A), J1.13, J1.14, J1.15, J11.1, J11.3, J12.1, J12.3, J13.1, J13.3, J14.1, J14.3
GND: J1.4, J1.5, J1.6, J1.10, J1.12, J1.MP (MountPin), J2.1, J2.3, J3.1, J3.3, J4.2, J15.4, J17.2, J18.1, J18.6, R15.2, R16.2, R17.2, R18.2, U1.13 (GND)
unnamed: D1.1 (K), J4.1
unnamed: J2.2, J5.2
unnamed: J2.4, J5.1
unnamed: J3.2, J6.2
unnamed: J3.4, J6.1
unnamed: J10.1, J10.2, J14.2, J14.4, J14.6, J14.8, J14.10, J14.12
unnamed: J7.1, J7.2, J11.2, J11.4, J11.6, J11.8, J11.10, J11.12
unnamed: J12.5, J12.7, R1.2, R2.1, R4.2, R5.1
unnamed: J8.1, J8.2, J12.2, J12.4, J12.6, J12.8, J12.10, J12.12
unnamed: J12.9, J12.11, R7.2, R8.1, R10.2, R11.1
unnamed: J13.5, J13.7, R2.2, R3.1, R5.2, R6.1
unnamed: J9.1, J9.2, J13.2, J13.4, J13.6, J13.8, J13.10, J13.12
unnamed: J13.9, J13.11, R8.2, R9.1, R11.2, R12.1
unnamed: J14.5, R3.2
unnamed: J14.7, R6.2
unnamed: J14.9, R9.2
unnamed: J14.11, R12.2
unnamed: J15.2, J16.6, R13.2, U1.6 (GPIO7/SCL)
unnamed: J15.3, J16.5, R14.2, U1.5 (GPIO6/SDA)
unnamed: J16.1, J18.2, R15.1, U1.1 (GPIO26/ADC0/A0)
unnamed: J16.2, U1.2 (GPIO27/ADC1/A1)
unnamed: J16.3, U1.3 (GPIO28/ADC2/A2)
unnamed: J16.4, U1.4 (GPIO29/ADC3/A3)
unnamed: J16.7, U1.7 (GPIO0/TX)
unnamed: J17.1, U1.14 (VBUS)
unnamed: J17.4, J18.3, R16.1, U1.11 (GPIO3/MOSI)
unnamed: J17.5, J18.4, R17.1, U1.10 (GPIO4/MISO)
unnamed: J17.6, J18.5, R18.1, U1.9 (GPIO2/SCK)
unnamed: J17.7, U1.8 (GPIO1/RX)

Notes on the sheet:
To AE-RELAY4-BOARD (6P header)
Distribution selector 4
Distribution selector 1
To AE-RELAY4-BOARD (2P terminal)
Relay control power
(As test pin)
Terminal for GND/Common wire
Switching controller (Default : Not mounted)
Distribution selector 2
Distribution selector 3
I2C test port (3.3V only)
SATA Power Input

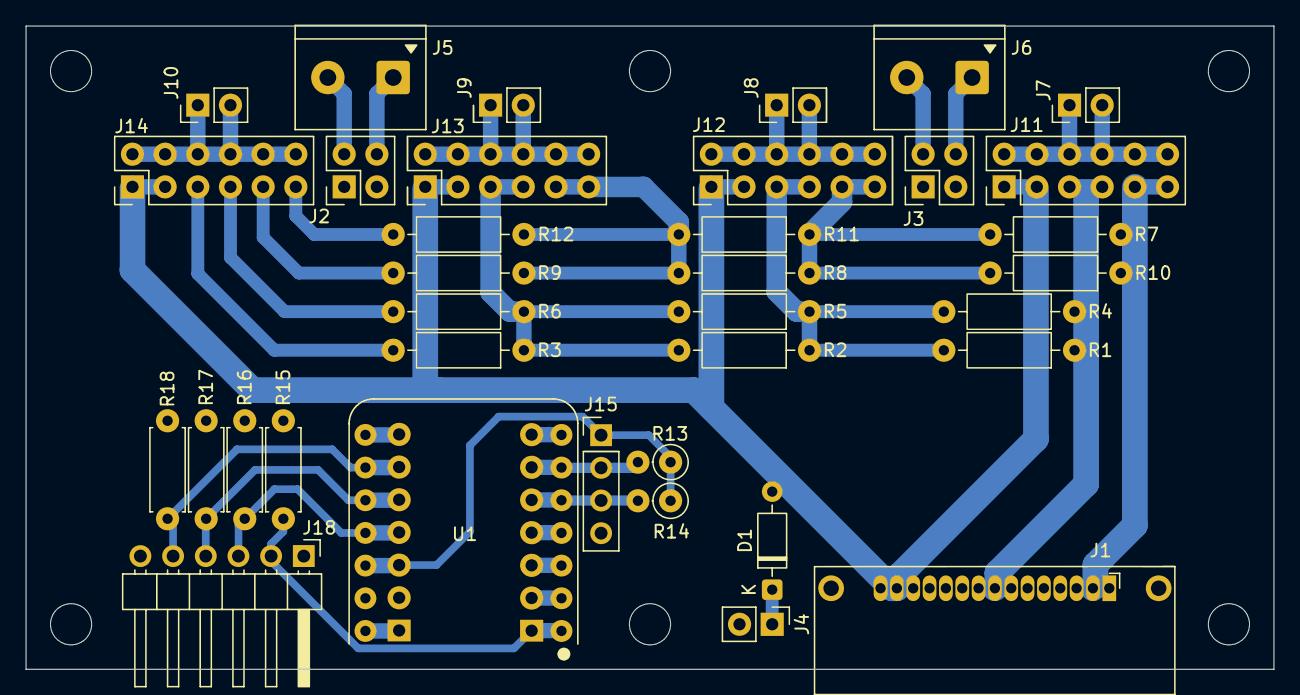
[picture p60: board AE-RELAY4-BOARD_SATA-Ctrl_A.kicad_pcb from above]

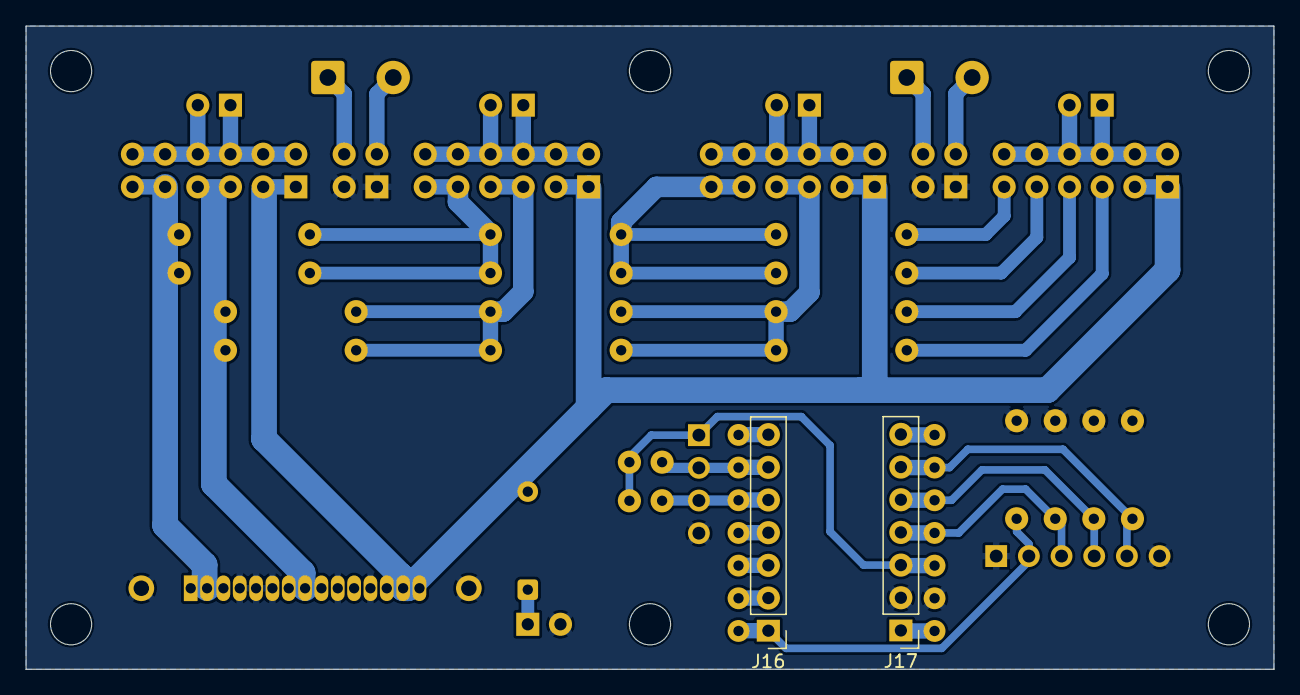
[picture p61: board AE-RELAY4-BOARD_SATA-Ctrl_A.kicad_pcb from below]

Board: 2 copper layers, 97.0 x 50.0 mm, 44 parts (2 on the bottom side), 34 nets.

Other parts of the board:
MH1, MH1#2, MH1#3, MH1#4, MH1#5, MH1#6: MountingHole_3.2mm_M3
