takinoya/EvbPusher/Supplemental/SFX-Breakout/KiCad/SFX-BO-01/SFX-BO-01.kicad_pcb

## KiCad design Supplemental/SFX-Breakout/KiCad/SFX-BO-01/SFX-BO-01.kicad_pcb (2026-03-12)

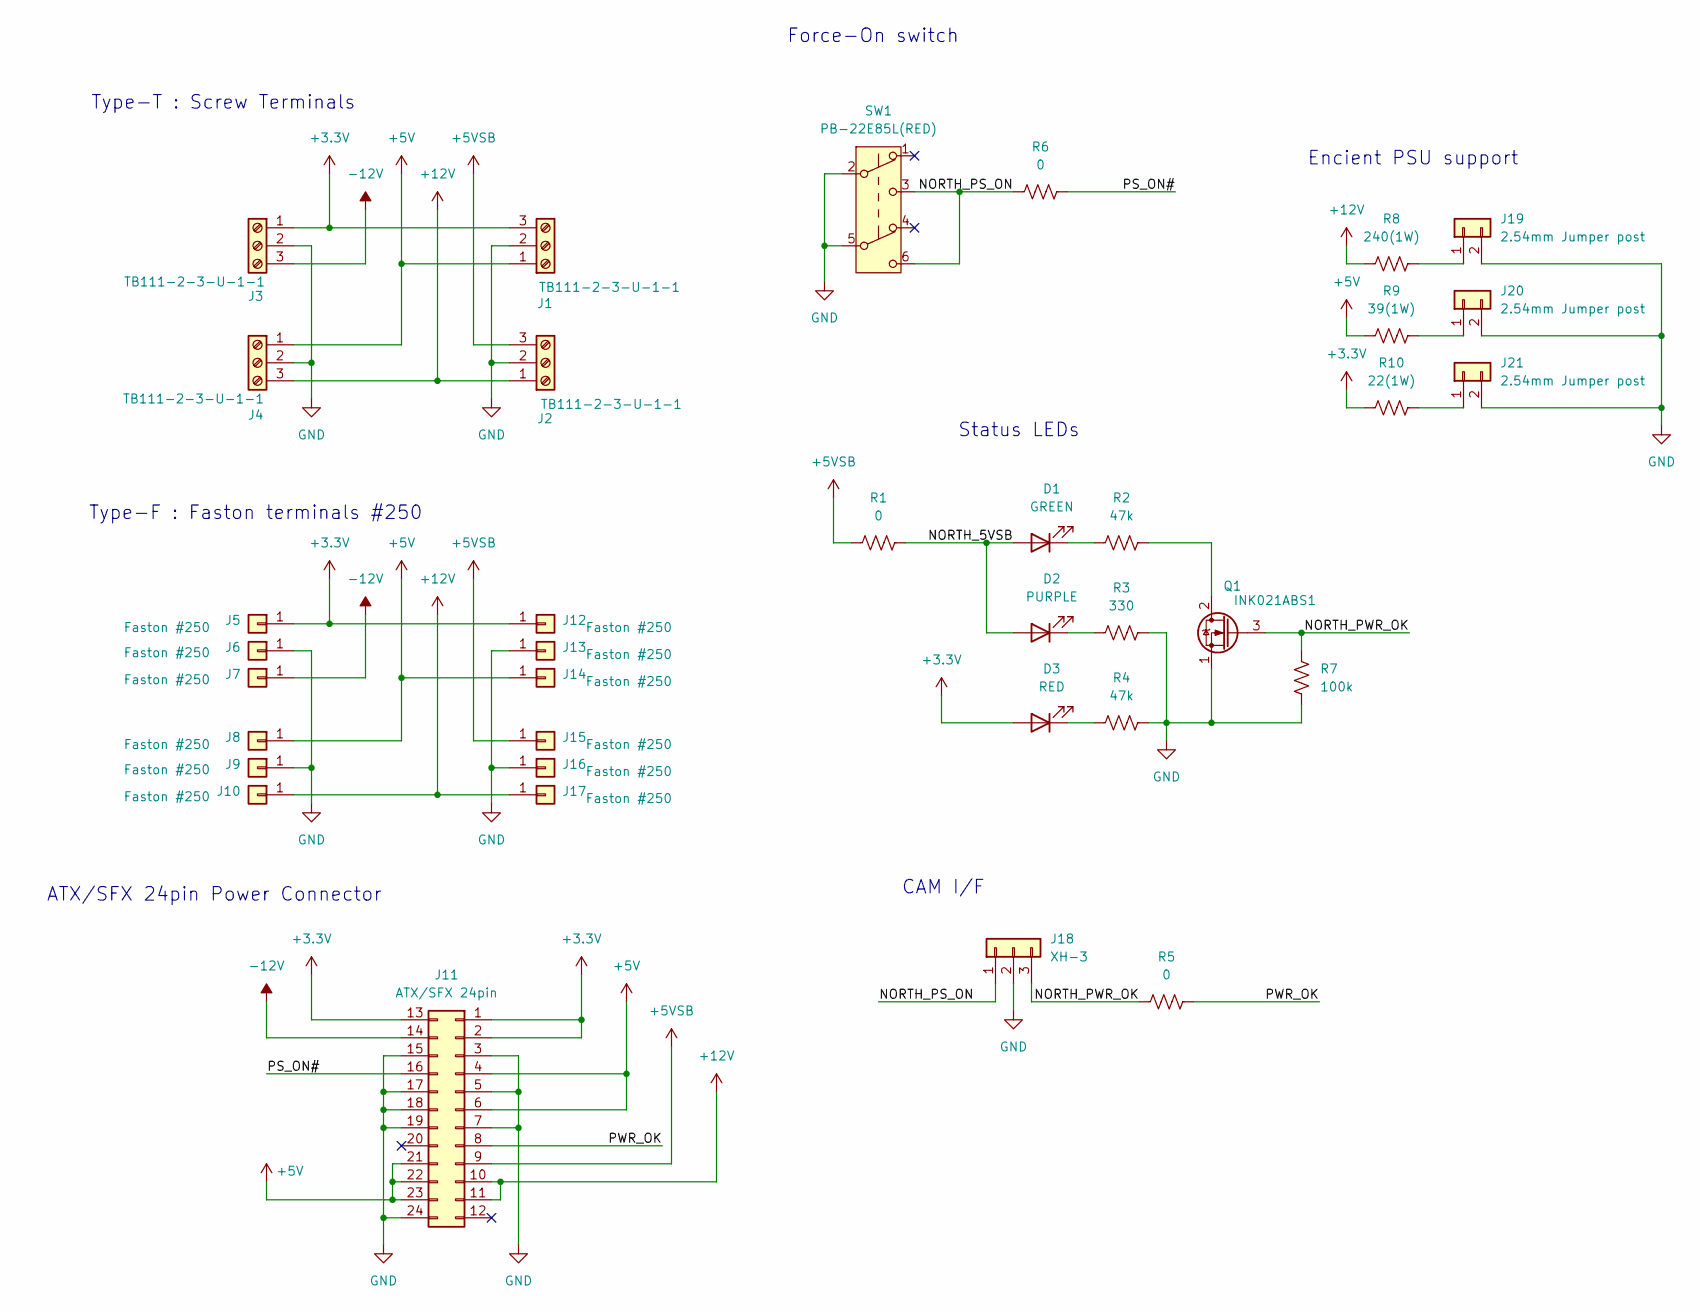
[picture p62: schematic SFX-BO-01.kicad_sch, SFX Breakout board （EvbPusher project)]

Parts:
D1: GREEN; LED_D3.0mm
D2: PURPLE; LED_D3.0mm
D3: RED; LED_D3.0mm
J1, J2, J3, J4: TB111-2-3-U-1-1; TerminalBlock_Alphaplus_TB111-2-3-U-1-1_1x03_P5.08mm_Horizo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
J5, J6, J7, J8, J9, J10, J12, J13, J14, J15, J16, J17: Faston #250; Faston_PC250
J11: ATX/SFX 24pin; Molex_Mini-Fit_Jr_5566-24A_2x12_P4.20mm_Vertical
J18: XH-3; JST_XH_B3B-XH-A_1x03_P2.50mm_Vertical
J19, J20, J21: 2.54mm Jumper post; PinHeader_1x02_P2.54mm_nomargin_Vertical
Q1: INK021ABS1; TO-92S_Wide_TMVC
R1, R5, R6: 0; R_Axial_DIN0207_L6.3mm_D2.5mm_P15.24mm_Horizontal_TOSA
R2, R4: 47k; R_Axial_DIN0207_L6.3mm_D2.5mm_P2.54mm_Vertical_TOSA
R3: 330; R_Axial_DIN0207_L6.3mm_D2.5mm_P2.54mm_Vertical_TOSA
R7: 100k; R_Axial_DIN0207_L6.3mm_D2.5mm_P2.54mm_Vertical_TOSA
R8: 240(1W); R_Axial_DIN0207_L6.3mm_D2.5mm_P2.54mm_Vertical_TOSA
R9: 39(1W); R_Axial_DIN0207_L6.3mm_D2.5mm_P2.54mm_Vertical_TOSA
R10: 22(1W); R_Axial_DIN0207_L6.3mm_D2.5mm_P2.54mm_Vertical_TOSA
SW1: PB-22E85L(RED); SW_Push_2P2T_Toggle_PB-22E85L

Connections:
+3.3V: D3.2 (A), J1.3, J3.1, J5.1, J11.1, J11.2, J11.13, J12.1, R10.1
+5V: J1.1, J4.1, J8.1, J11.4, J11.6, J11.21, J11.22, J11.23, J14.1, R9.1
+5VSB: J2.3, J11.9, J15.1, R1.1
+12V: J2.1, J4.3, J10.1, J11.10, J11.11, J17.1, R8.1
-12V: J3.3, J7.1, J11.14
/NORTH_5VSB: D1.2 (A), D2.2 (A), R1.2
/NORTH_PS_ON: J18.1, R6.1, SW1.3 (C), SW1.6 (C)
/NORTH_PWR_OK: J18.3, Q1.3 (G), R5.1, R7.2
/PS_ON#: J11.16, R6.2
/PWR_OK: J11.8, R5.2
GND: J1.2, J2.2, J3.2, J4.2, J6.1, J9.1, J11.3, J11.5, J11.7, J11.15, J11.17, J11.18, J11.19, J11.24, J13.1, J16.1, J18.2, J19.2, J20.2, J21.2, Q1.1 (S), R3.2, R4.2, R7.1, SW1.2 (B), SW1.5 (B)
unnamed: D1.1 (K), R2.1
unnamed: D2.1 (K), R3.1
unnamed: D3.1 (K), R4.1
unnamed: J19.1, R8.2
unnamed: J20.1, R9.2
unnamed: J21.1, R10.2
unnamed: Q1.2 (D), R2.2

Notes on the sheet:
Type-T : Screw Terminals
CAM I/F
ATX/SFX 24pin Power Connector
Status LEDs
Encient PSU support
Type-F : Faston terminals #250
Force-On switch

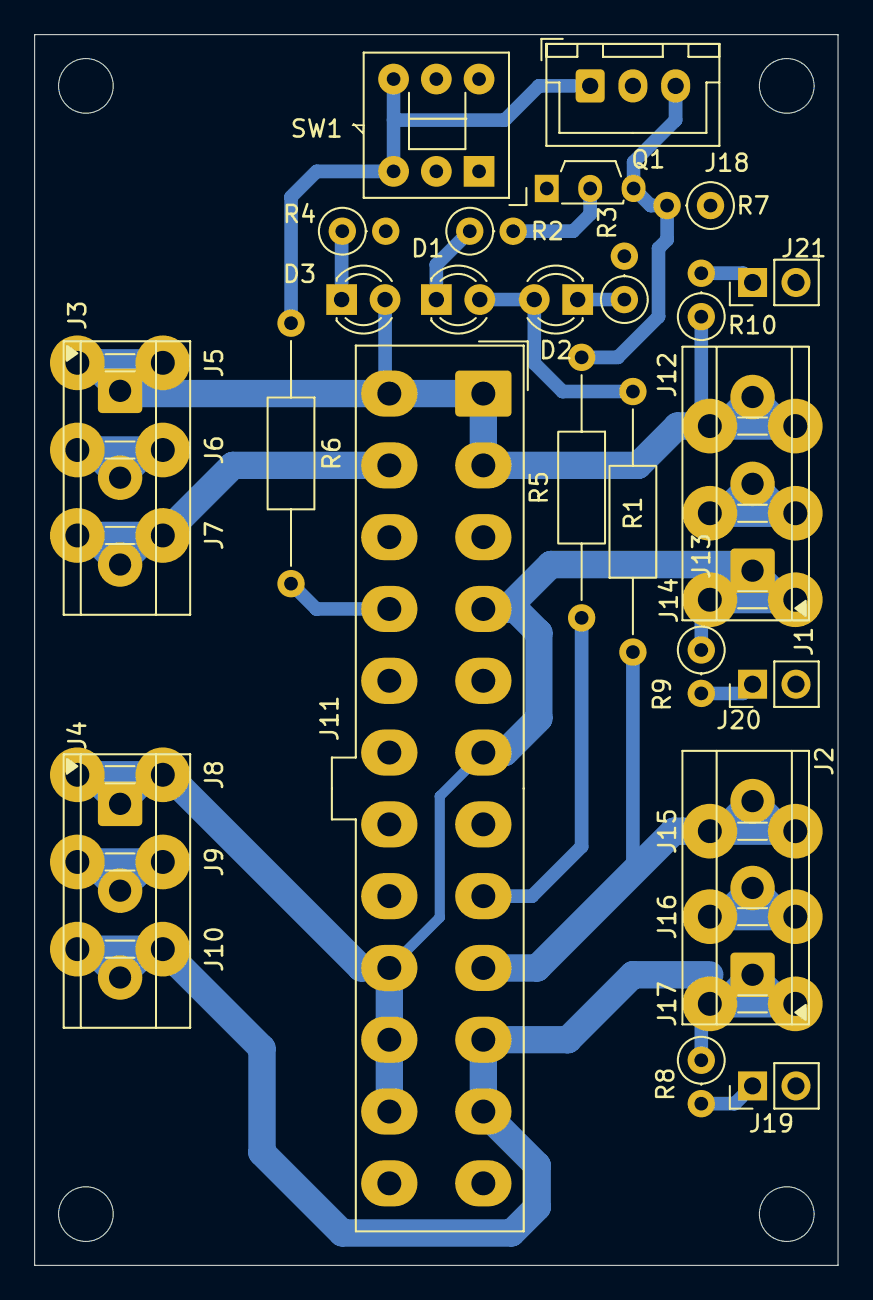
[picture p63: board SFX-BO-01.kicad_pcb from above]

Board: 2 copper layers, 47.0 x 72.0 mm, 40 parts (0 on the bottom side), 18 nets.

Other parts of the board:
MH1, MH2, MH3, MH4: MountingHole_3.2mm_M3
