takinoya/EvbPusher/MB-C2.Auduino_Nano_R4/KiCad/MB-C2/MB-C2.kicad_pcb

## KiCad design MB-C2.Auduino_Nano_R4/KiCad/MB-C2/MB-C2.kicad_pcb (2025-11-12)

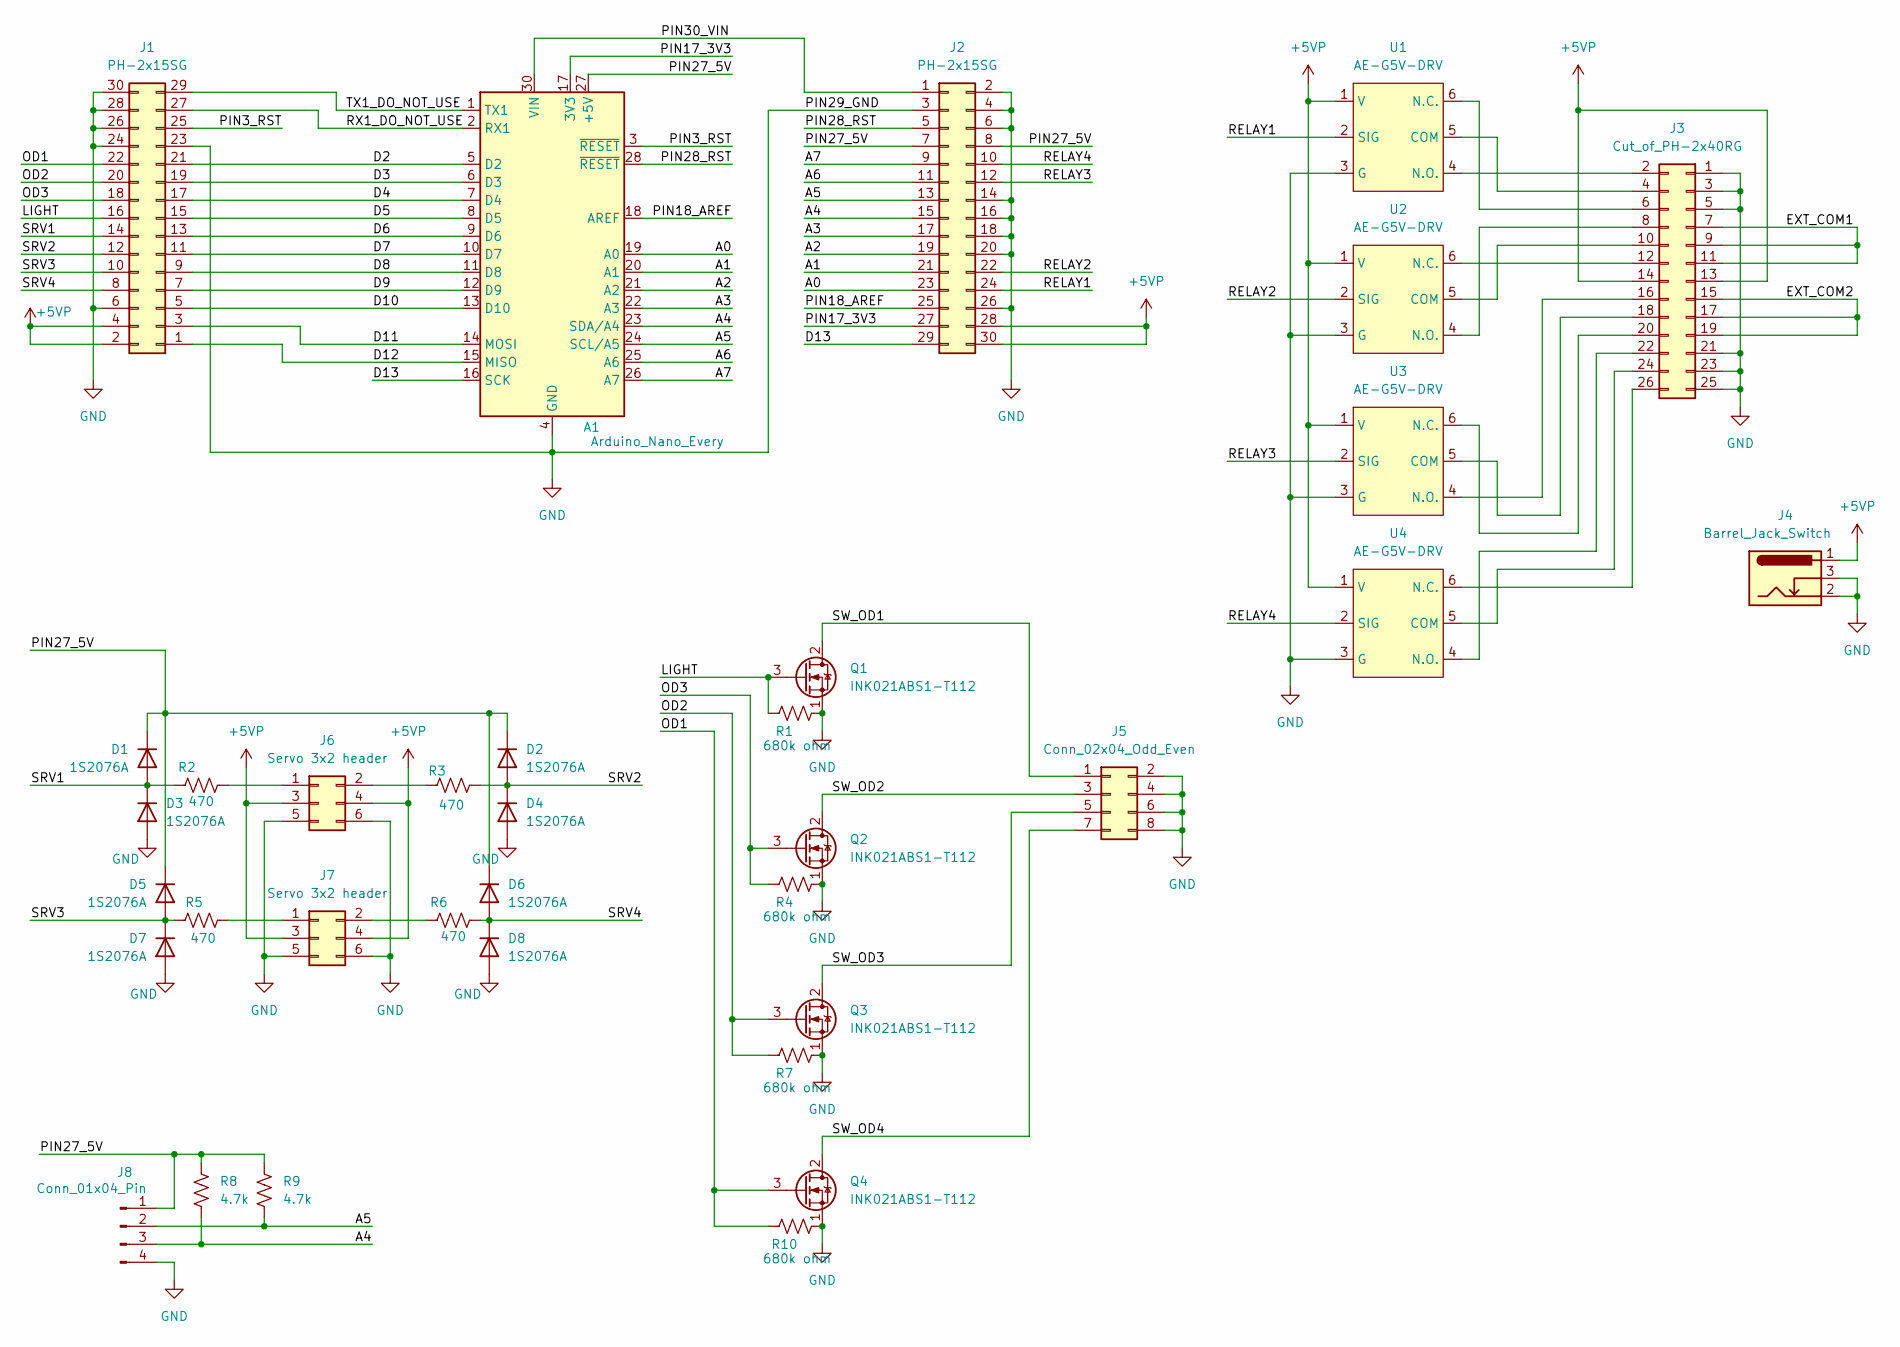
[picture p64: schematic MB-C2.kicad_sch]

Parts:
A1: Arduino_Nano_Every; Arduino_Nano__silk_tune
D1, D2, D3, D4, D5, D6, D7, D8: 1S2076A; D_DO-34_SOD68_P2.54mm_Vertical_KathodeUp
J1, J2: PH-2x15SG; PinHeader_2x15_P2.54mm_Vertical
J3: Cut_of_PH-2x40RG; PinHeader_2x13_P2.54mm_Vertical
J4: Barrel_Jack_Switch; BarrelJack_2.1mm_4A_18742_TMVC
J5: Conn_02x04_Odd_Even; PinHeader_2x04_P2.54mm_nomargin_Vertical
J6, J7: Servo 3x2 header; PinHeader_2x03_P2.54mm_nomargin_Vertical
J8: Conn_01x04_Pin; PinHeader_1x04_P2.54mm_Vertical
Q1, Q2, Q3, Q4: INK021ABS1-T112; TO-92S_Wide_TMVC
R1, R4, R7, R10: 680k ohm; R_Axial_DIN0204_L3.6mm_D1.6mm_P2.54mm_Vertical
R2, R5: 470; R_Axial_DIN0204_L3.6mm_D1.6mm_P5.08mm_Horizontal
R3, R6: 470; R_Axial_DIN0204_L3.6mm_D1.6mm_P2.54mm_Vertical
R8, R9: 4.7k; R_Axial_DIN0204_L3.6mm_D1.6mm_P7.62mm_Horizontal_TMVC
U1, U2, U3, U4: AE-G5V-DRV

Connections:
+5VP: J1.2, J1.4, J2.28, J2.30, J3.13, J3.14, J4.1, J6.3, J6.4, J7.3, J7.4, U1.1 (V), U2.1 (V), U3.1 (V), U4.1 (V)
/A0: A1.19 (A0), J2.23
/A1: A1.20 (A1), J2.21
/A2: A1.21 (A2), J2.19
/A3: A1.22 (A3), J2.17
/A4: A1.23 (SDA/A4), J2.15, J8.3, R8.2
/A5: A1.24 (SCL/A5), J2.13, J8.2, R9.2
/A6: A1.25 (A6), J2.11
/A7: A1.26 (A7), J2.9
/D2: A1.5 (D2), J1.21
/D3: A1.6 (D3), J1.19
/D4: A1.7 (D4), J1.17
/D5: A1.8 (D5), J1.15
/D6: A1.9 (D6), J1.13
/D7: A1.10 (D7), J1.11
/D8: A1.11 (D8), J1.9
/D9: A1.12 (D9), J1.7
/D10: A1.13 (D10), J1.5
/D11: A1.14 (MOSI), J1.3
/D12: A1.15 (MISO), J1.1
/D13: A1.16 (SCK), J2.29
/EXT_COM1: J3.7, J3.9, J3.11
/EXT_COM2: J3.15, J3.17, J3.19
/LIGHT: J1.16, Q1.3 (G), R1.1
/OD1: J1.22, Q4.3 (G), R10.1
/OD2: J1.20, Q3.3 (G), R7.1
/OD3: J1.18, Q2.3 (G), R4.1
/PIN3_RST: A1.3 (~RESET), J1.25
/PIN17_3V3: A1.17 (3V3), J2.27
/PIN18_AREF: A1.18 (AREF), J2.25
/PIN27_5V: A1.27 (+5V), D1.1 (K), D2.1 (K), D5.1 (K), D6.1 (K), J2.7, J2.8, J8.1, R8.1, R9.1
/PIN28_RST: A1.28 (~RESET), J2.5
/PIN30_VIN: A1.30 (VIN), J2.1
/RELAY1: J2.24, U1.2 (SIG)
/RELAY2: J2.22, U2.2 (SIG)
/RELAY3: J2.12, U3.2 (SIG)
/RELAY4: J2.10, U4.2 (SIG)
/RX1_DO_NOT_USE: A1.2 (RX1), J1.27
/SRV1: D1.2 (A), D3.1 (K), J1.14, R2.1
/SRV2: D2.2 (A), D4.1 (K), J1.12, R3.2
/SRV3: D5.2 (A), D7.1 (K), J1.10, R5.1
/SRV4: D6.2 (A), D8.1 (K), J1.8, R6.2
/SW_OD1: J5.1, Q1.2 (D)
/SW_OD2: J5.3, Q2.2 (D)
/SW_OD3: J5.5, Q3.2 (D)
/SW_OD4: J5.7, Q4.2 (D)
/TX1_DO_NOT_USE: A1.1 (TX1), J1.29
GND: A1.4 (GND), A1.29 (GND), D3.2 (A), D4.2 (A), D7.2 (A), D8.2 (A), J1.6, J1.23, J1.24, J1.26, J1.28, J1.30, J2.2, J2.3, J2.4, J2.6, J2.14, J2.16, J2.18, J2.20, J2.26, J3.1, J3.3, J3.5, J3.21, J3.23, J3.25, J4.2, J4.3, J5.2, J5.4, J5.6, J5.8, J6.5, J6.6, J7.5, J7.6, J8.4, Q1.1 (S), Q2.1 (S), Q3.1 (S), Q4.1 (S), R1.2, R4.2, R7.2, R10.2, U1.3 (G), U2.3 (G), U3.3 (G), U4.3 (G)
unnamed: J3.2, U1.4 (N.O.)
unnamed: J3.4, U1.5 (COM)
unnamed: J3.6, U1.6 (N.C.)
unnamed: J3.8, U2.4 (N.O.)
unnamed: J3.10, U2.5 (COM)
unnamed: J3.12, U2.6 (N.C.)
unnamed: J3.16, U3.4 (N.O.)
unnamed: J3.18, U3.5 (COM)
unnamed: J3.20, U3.6 (N.C.)
unnamed: J3.22, U4.4 (N.O.)
unnamed: J3.24, U4.5 (COM)
unnamed: J3.26, U4.6 (N.C.)
unnamed: J6.1, R2.2
unnamed: J6.2, R3.1
unnamed: J7.1, R5.2
unnamed: J7.2, R6.1

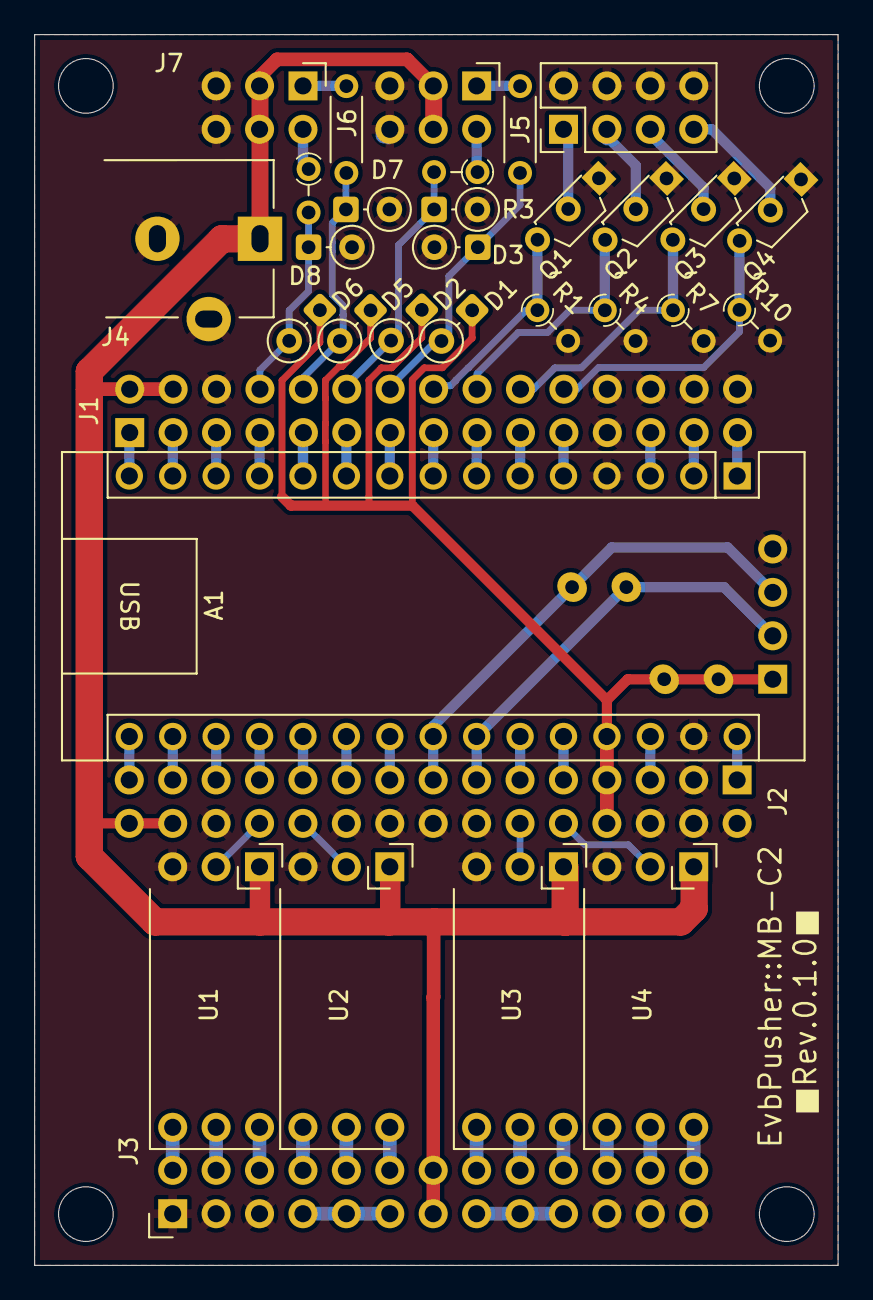
[picture p65: board MB-C2.kicad_pcb from above]

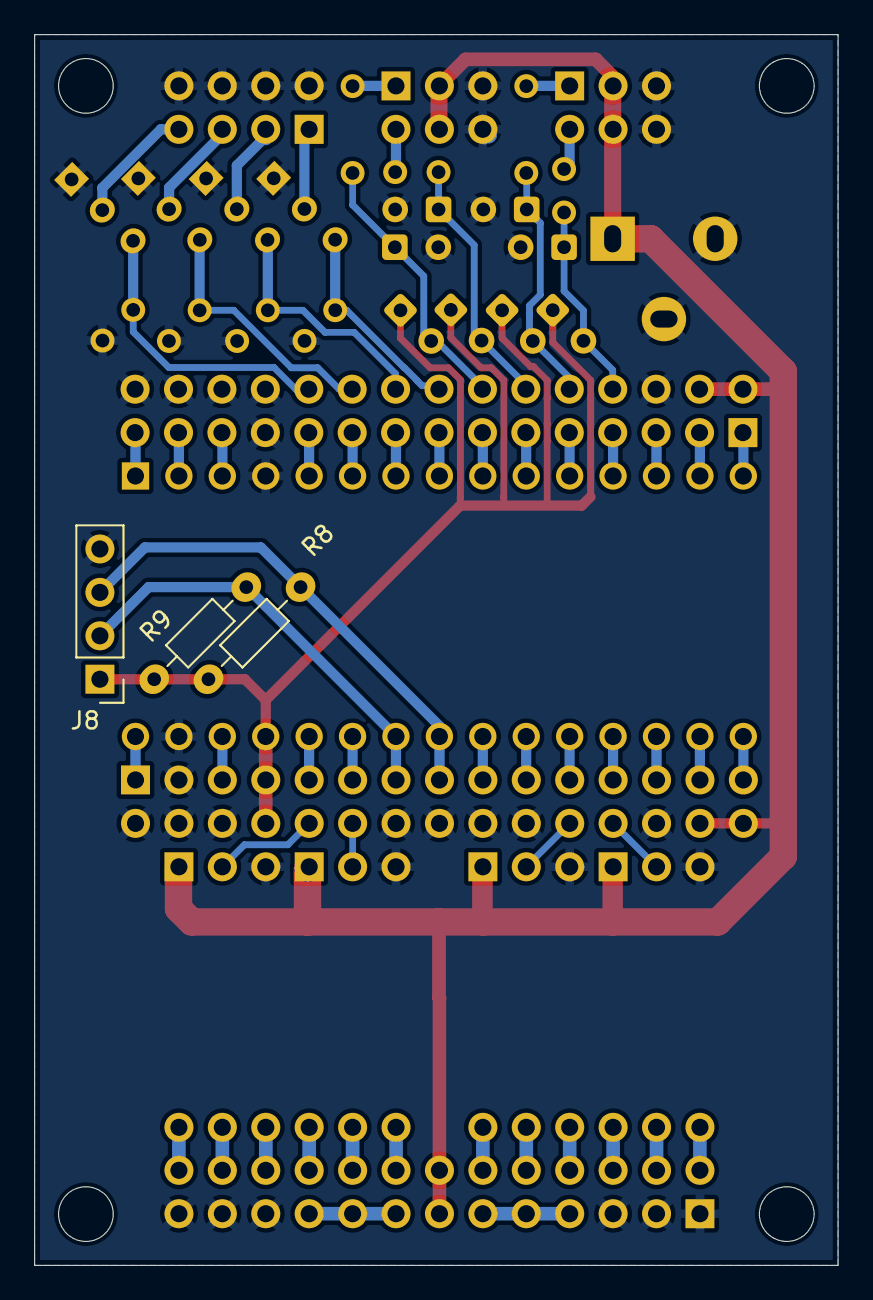
[picture p66: board MB-C2.kicad_pcb from below]

Board: 2 copper layers, 47.0 x 72.0 mm, 39 parts (3 on the bottom side), 64 nets.

Other parts of the board:
MH1, MH2, MH3, MH4: MountingHole_3.2mm_M3
