takinoya/EvbPusher/MB-C1.Arduino_Nano_Every/kicad/EVBPusher_nano/EVBPusher_nano.kicad_pcb

## KiCad design MB-C1.Arduino_Nano_Every/kicad/EVBPusher_nano/EVBPusher_nano.kicad_pcb (2025-10-31)

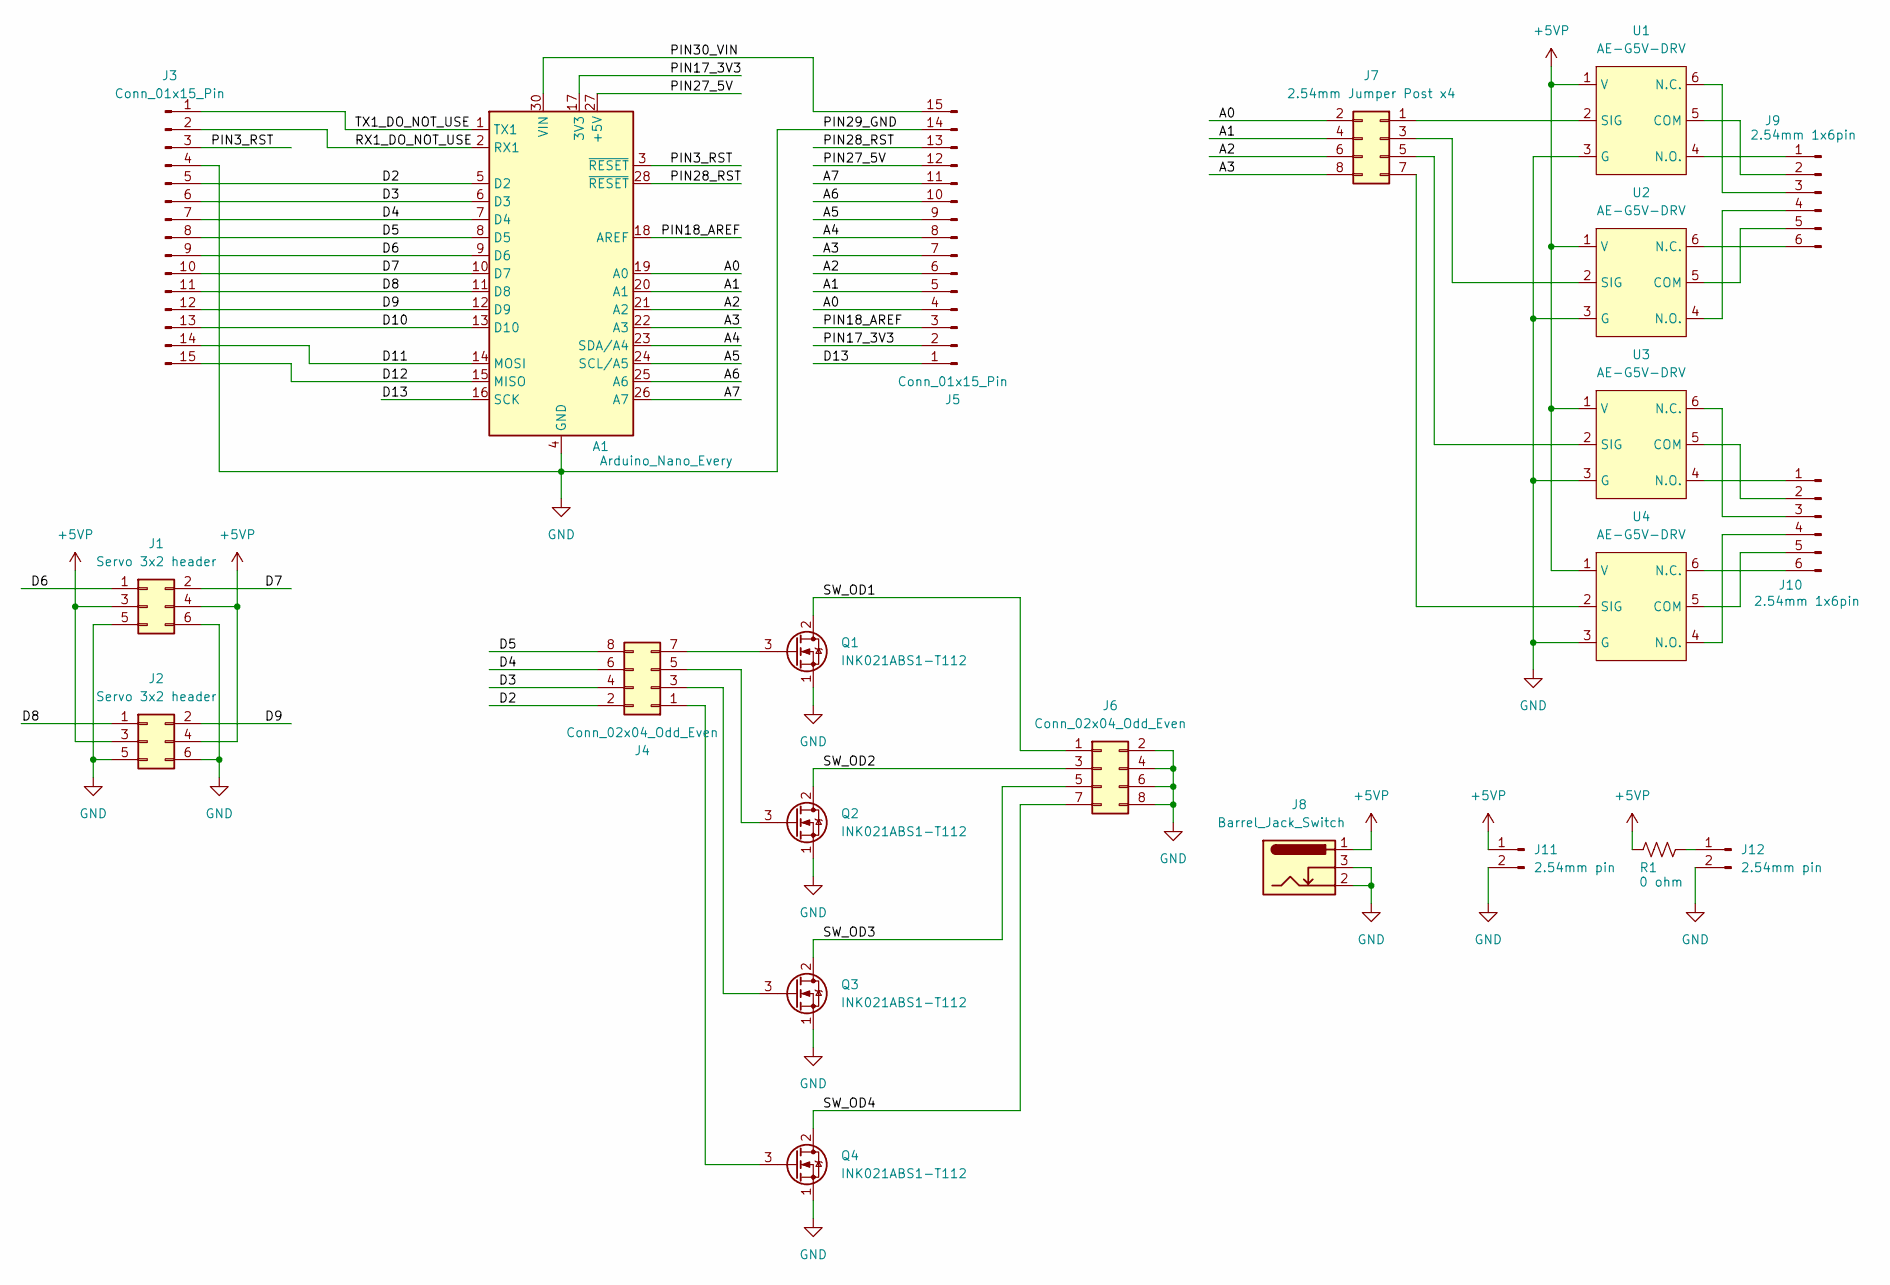
[picture p67: schematic EVBPusher_nano.kicad_sch]

Parts:
A1: Arduino_Nano_Every; Arduino_Nano
J1, J2: Servo 3x2 header; PinHeader_2x03_P2.54mm_nomargin_Vertical
J3, J5: Conn_01x15_Pin; PinHeader_1x15_P2.54mm_nomargein_Vertical
J4, J6: Conn_02x04_Odd_Even; PinHeader_2x04_P2.54mm_nomargin_Vertical
J7: 2.54mm Jumper Post x4; PinHeader_2x04_P2.54mm_nomargin_Vertical
J8: Barrel_Jack_Switch; BarrelJack_2.1mm_4A_18742_TMVC
J9, J10: 2.54mm 1x6pin; PinHeader_1x06_P2.54mm_nomargin_Vertical
J11, J12: 2.54mm pin; PinHeader_1x02_P2.54mm_nomargin_Vertical
Q1, Q2, Q3, Q4: INK021ABS1-T112; TO-92S_Wide_TMVC
R1: 0 ohm; R_Axial_DIN0204_L3.6mm_D1.6mm_P7.62mm_Horizontal_TMVC
U1, U2, U3, U4: AE-G5V-DRV

Connections:
+5VP: J1.3, J1.4, J2.3, J2.4, J8.1, J11.1, R1.1, U1.1 (V), U2.1 (V), U3.1 (V), U4.1 (V)
/A0: A1.19 (A0), J5.4, J7.2
/A1: A1.20 (A1), J5.5, J7.4
/A2: A1.21 (A2), J5.6, J7.6
/A3: A1.22 (A3), J5.7, J7.8
/A4: A1.23 (SDA/A4), J5.8
/A5: A1.24 (SCL/A5), J5.9
/A6: A1.25 (A6), J5.10
/A7: A1.26 (A7), J5.11
/D2: A1.5 (D2), J3.5, J4.2
/D3: A1.6 (D3), J3.6, J4.4
/D4: A1.7 (D4), J3.7, J4.6
/D5: A1.8 (D5), J3.8, J4.8
/D6: A1.9 (D6), J1.1, J3.9
/D7: A1.10 (D7), J1.2, J3.10
/D8: A1.11 (D8), J2.1, J3.11
/D9: A1.12 (D9), J2.2, J3.12
/D10: A1.13 (D10), J3.13
/D11: A1.14 (MOSI), J3.14
/D12: A1.15 (MISO), J3.15
/D13: A1.16 (SCK), J5.1
/PIN3_RST: A1.3 (~RESET), J3.3
/PIN17_3V3: A1.17 (3V3), J5.2
/PIN18_AREF: A1.18 (AREF), J5.3
/PIN27_5V: A1.27 (+5V), J5.12
/PIN28_RST: A1.28 (~RESET), J5.13
/PIN30_VIN: A1.30 (VIN), J5.15
/RX1_DO_NOT_USE: A1.2 (RX1), J3.2
/SW_OD1: J6.1, Q1.2 (D)
/SW_OD2: J6.3, Q2.2 (D)
/SW_OD3: J6.5, Q3.2 (D)
/SW_OD4: J6.7, Q4.2 (D)
/TX1_DO_NOT_USE: A1.1 (TX1), J3.1
GND: A1.4 (GND), A1.29 (GND), J1.5, J1.6, J2.5, J2.6, J3.4, J5.14, J6.2, J6.4, J6.6, J6.8, J8.2, J8.3, J11.2, J12.2, Q1.1 (S), Q2.1 (S), Q3.1 (S), Q4.1 (S), U1.3 (G), U2.3 (G), U3.3 (G), U4.3 (G)
unnamed: J4.1, Q4.3 (G)
unnamed: J4.3, Q3.3 (G)
unnamed: J4.5, Q2.3 (G)
unnamed: J4.7, Q1.3 (G)
unnamed: J7.1, U1.2 (SIG)
unnamed: J7.3, U2.2 (SIG)
unnamed: J7.5, U3.2 (SIG)
unnamed: J7.7, U4.2 (SIG)
unnamed: J9.1, U1.4 (N.O.)
unnamed: J9.2, U1.5 (COM)
unnamed: J9.3, U1.6 (N.C.)
unnamed: J9.4, U2.4 (N.O.)
unnamed: J9.5, U2.5 (COM)
unnamed: J9.6, U2.6 (N.C.)
unnamed: J10.1, U3.4 (N.O.)
unnamed: J10.2, U3.5 (COM)
unnamed: J10.3, U3.6 (N.C.)
unnamed: J10.4, U4.4 (N.O.)
unnamed: J10.5, U4.5 (COM)
unnamed: J10.6, U4.6 (N.C.)
unnamed: J12.1, R1.2

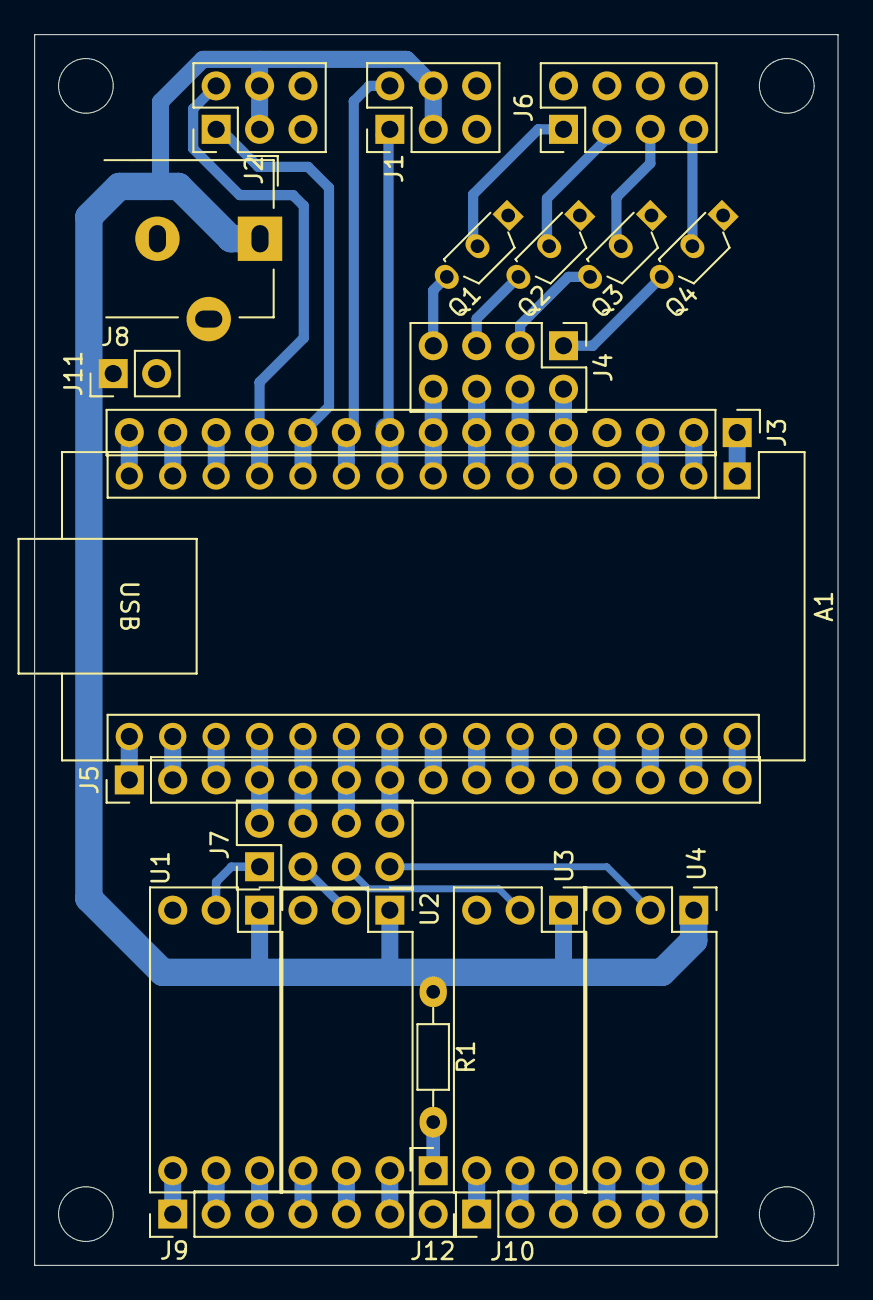
[picture p68: board EVBPusher_nano.kicad_pcb from above]

Board: 2 copper layers, 47.0 x 72.0 mm, 26 parts (0 on the bottom side), 55 nets.

Other parts of the board:
MH1, MH2, MH3, MH4: MountingHole_3.2mm_M3
