takinoya/EvbPusher/(commit log)

2025-10-14 1st import firmware to MB-C1.Arduino_Nano_Every.
2025-10-30 [FIRM::Nano] Add I2C* command mockup to avoid compile error
    [91_cmdline.ino]
2025-10-31 [MB-C1::HW] Import 3D/CAD design for MB-C1 shell
    [01_Bottom_panel_v2-Body.3mf, 01_Bottom_panel_v2.FCStd, 02_Top_main_v2-Body.3mf, 02_Top_main_v2.FCStd]
2025-10-31 [MB-C1] Import KiCad related files and factory data
    [EVBPusher_nano.kicad_pcb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]
2025-11-02 [MB-C1] Add gitignore for kicad files
2025-11-02 [MB-C1:Firm] Bug fix to load tunables
    [11_eeprom.ino]
2025-11-09 [MB-C1:Firm] Bug fix around PUSH/PULL
    [91_cmdline.ino, sketch_EVB-Pusher_AVR.ino]
2025-11-11 Import misc files
    [Nut_M3x2.54_M4-outer.FCStd, ORCA.Shell_for_AE-RELAY953B.3mf, Object_1_PLA_33m37s.gcode.3mf, Shell_for_AE-RELAY953B-5V-Bottom-panel-Body.3mf, Shell_for_AE-RELAY953B-5V-Top-Cover-Body.3mf, Shell_for_AE-RELAY953B-5V.FCStd, Thumb-Nut-A_M3x10_M6-outer.FCStd]
2025-11-12 1st import MB-C2 KiCAD data
    [MB-C2.kicad_pcb, MB-C2.kicad_sch]
2025-11-12 1st import MB-C2 shell design
    [01_Bottom_panel.3mf, 02_Main_body.3mf, Bambu-A1M0p4_PLA_48m32s.gcode.3mf, MB-C2_Shell.FCStd, ORCA.Bambu-A1M0p4.3mf]
2025-11-12 [MB-C2:KiCAD] Change to double side PCB
    - Change design rule to JLCPB capability.
    - Remove jumper resisters.
    - Migrate power lines to front side.
    [MB-C2.kicad_pcb, MB-C2.kicad_sch]
2025-11-17 [Misc:Thumb-Nut] Bug fix : outer size doubled
    [Thumb-Nut-A_M3x10_M6-outer.FCStd]
2025-11-23 Cleanup Misc and documantation files
    [Nut_M3x2.54_M4-outer.FCStd, Thumb-Nut-A_M3x10_M6-outer.FCStd, Thumb-Screw-Cap_A_M3_M6-outer-Cap-body.3mf, Thumb-Screw-Cap_A_M3_M6-outer-Main-body.3mf, Thumb-Screw-Cap_A_M3_M6-outer.FCStd]
2025-11-23 [MB-C2:KiCad] Add production data for JLCPCB
2025-11-23 [Supplemental/SFX-Breakout] 1st import
    [SFX-BO-01.kicad_pcb, SFX-BO-01.kicad_sch]
2025-12-15 [MB-C2:KiCad] Add PDF of schematic
2026-03-12 [SFX-BO-01] Snapshot to 1st PCB build
    [SFX-BO-01-B_Cu.gbl, SFX-BO-01-B_Mask.gbs, SFX-BO-01-B_Paste.gbp, SFX-BO-01-B_Silkscreen.gbo, SFX-BO-01-Edge_Cuts.gm1, SFX-BO-01-F_Cu.gtl, SFX-BO-01-F_Mask.gts, SFX-BO-01-F_Paste.gtp]
2026-03-12 [AE-RELAY4-BOARD_SATA-Ctrl_A] 1st import
    [AE-RELAY4-BOARD_SATA-Ctrl_A-B_Cu.gbr, AE-RELAY4-BOARD_SATA-Ctrl_A-B_Mask.gbr, AE-RELAY4-BOARD_SATA-Ctrl_A-B_Silkscreen.gbr, AE-RELAY4-BOARD_SATA-Ctrl_A-Edge_Cuts.gbr, AE-RELAY4-BOARD_SATA-Ctrl_A-F_Cu.gbr, AE-RELAY4-BOARD_SATA-Ctrl_A-F_Mask.gbr, AE-RELAY4-BOARD_SATA-Ctrl_A-F_Silkscreen.gbr, AE-RELAY4-BOARD_SATA-Ctrl_A-job.gbrjob]
2026-03-12 [FW.Arduino] 1st import
2026-03-13 [MB-C2] Snapshot 2026/Mar/13
    [01_Bottom_panel.3mf, 02_Main_body.3mf, MB-C2_CN-CAPs-CAP2.54pin-1x03_Body.3mf, MB-C2_CN-CAPs-CAP2.54pin-1x04_Body.3mf, MB-C2_CN-CAPs.FCStd, MB-C2_Shell.FCStd, ORCA.Bambu-A1M0p4.3mf]
